mrpackethead/bbb_eagle/BeagleBone_Black_egl.brd

## EAGLE design BeagleBone_Black_egl.brd (2013-08-05)

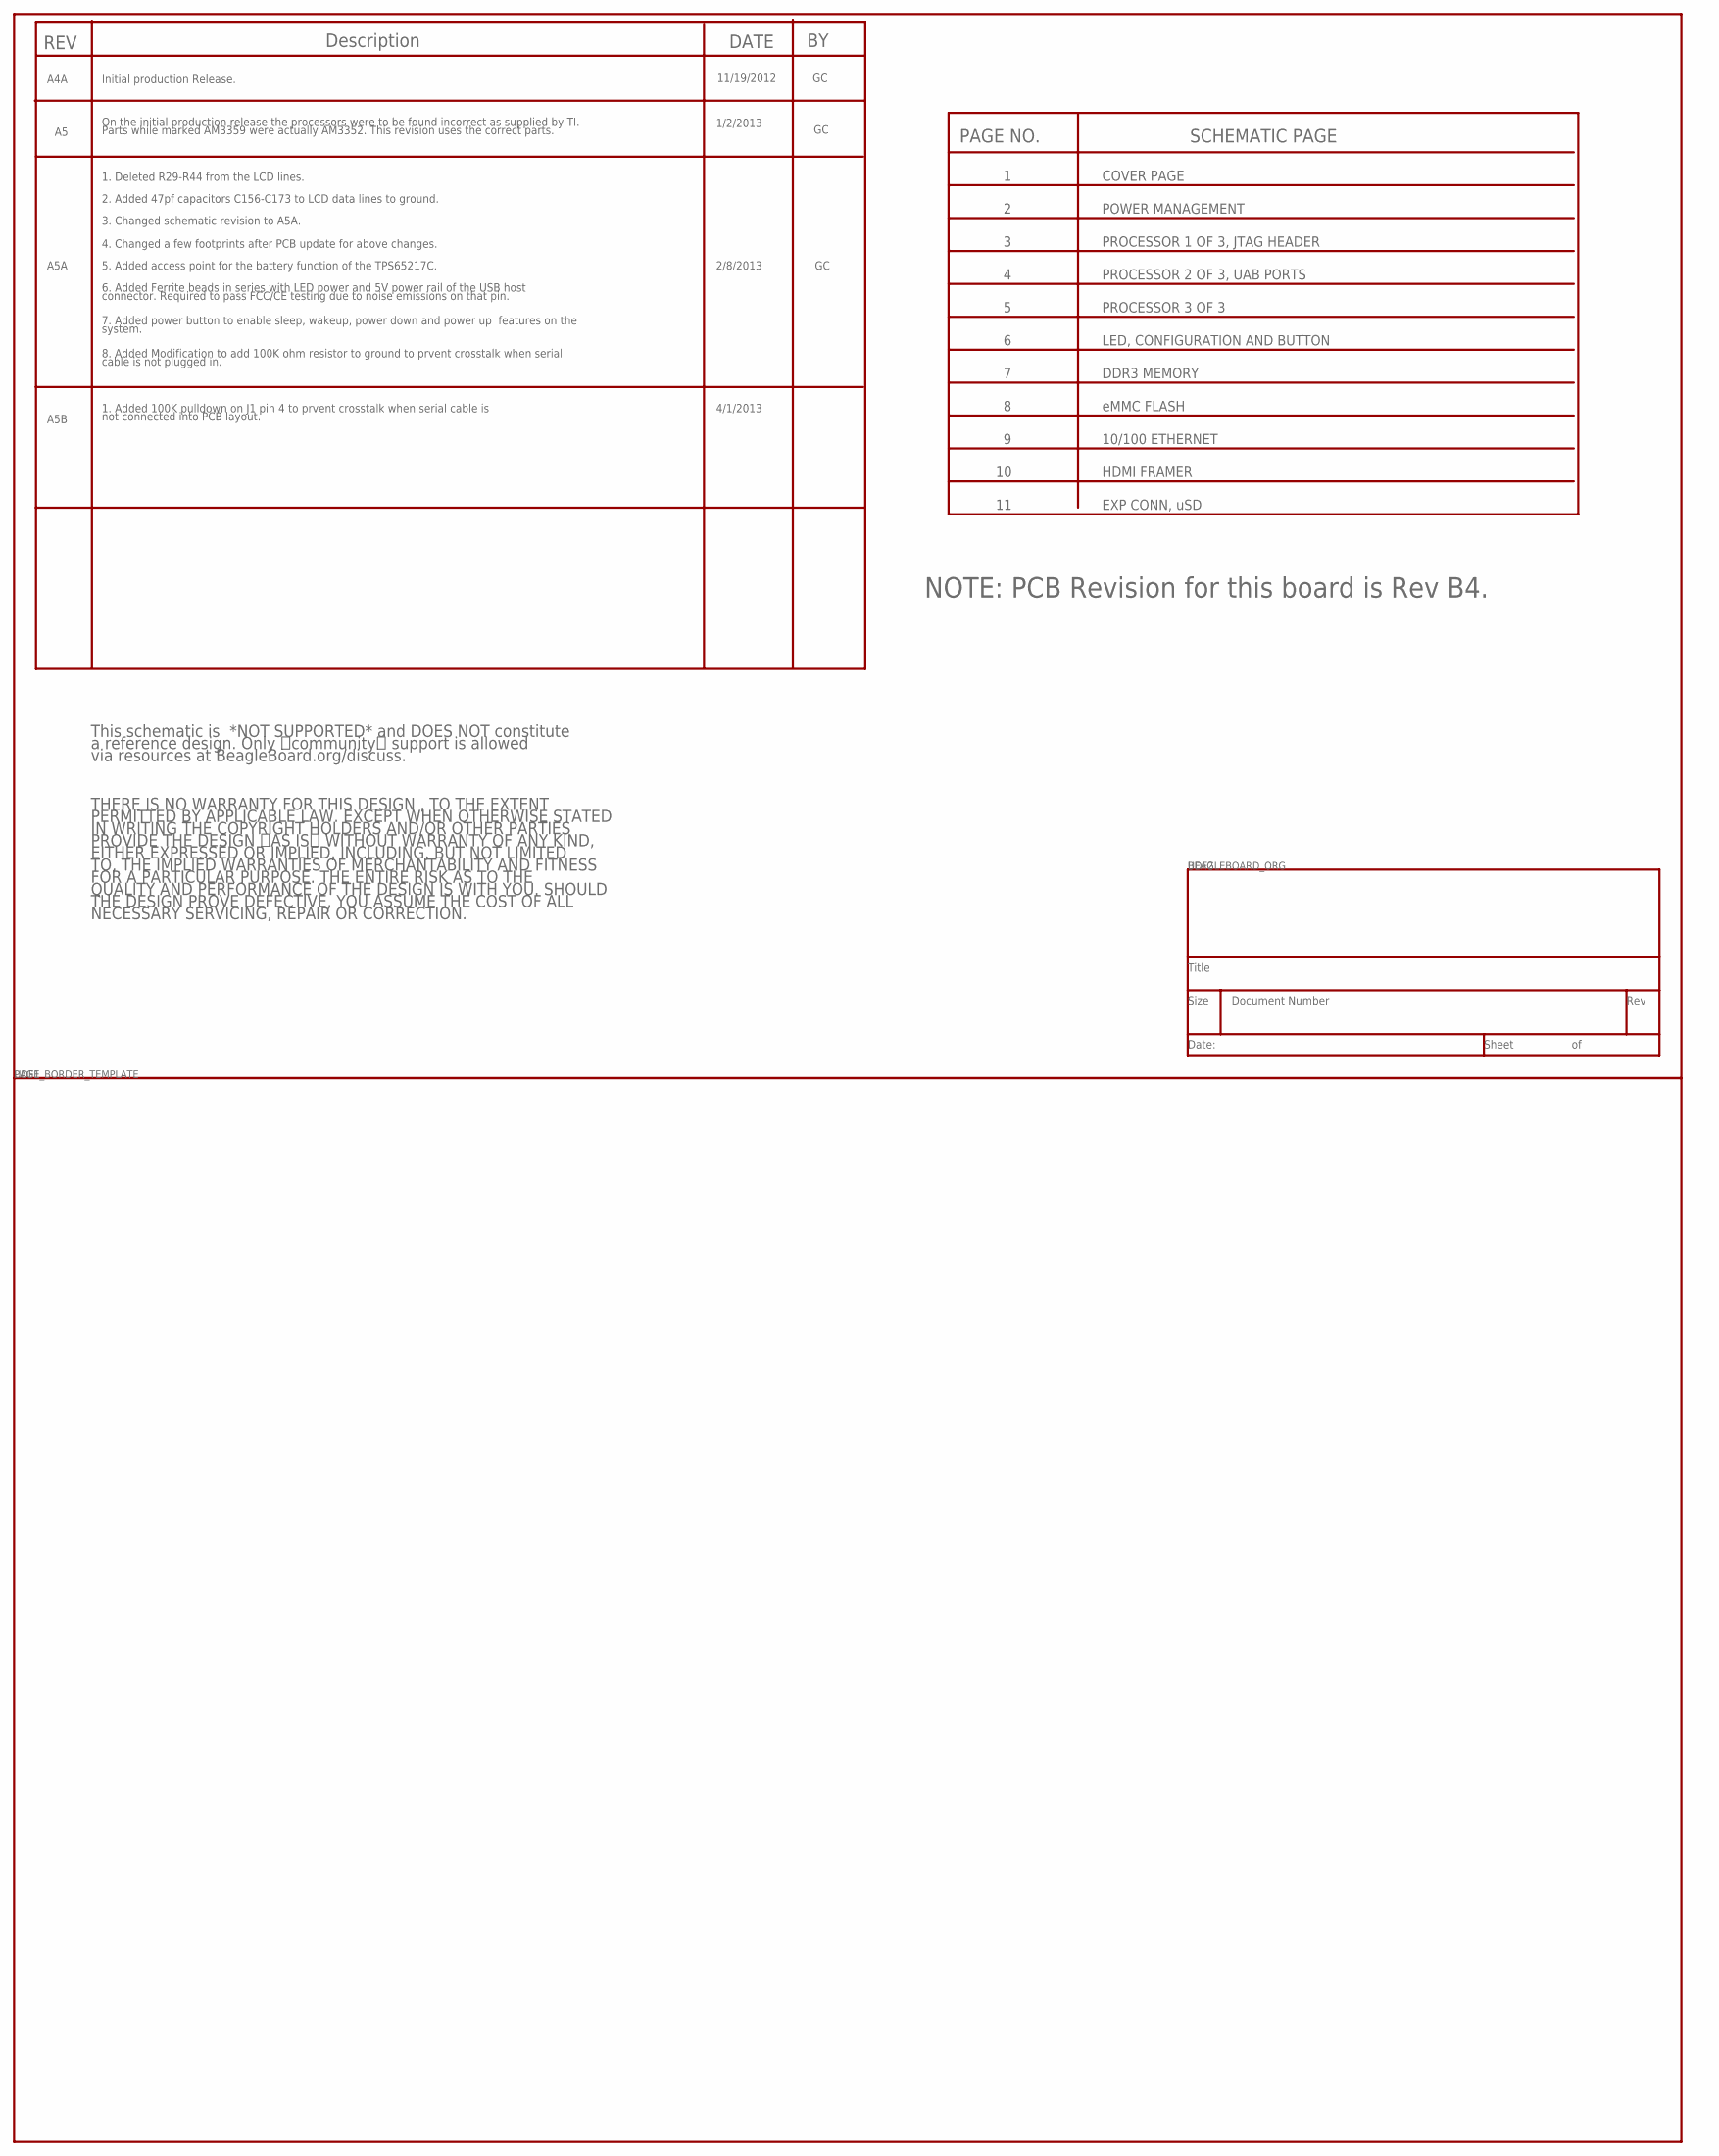
[picture p1: schematic BeagleBone_Black_egl.sch, sheet 1]

Notes on the sheet:
eMMC FLASH
HDMI FRAMER
10/100 ETHERNET
DDR3 MEMORY
PROCESSOR 2 OF 3, UAB PORTS
LED, CONFIGURATION AND BUTTON
SCHEMATIC PAGE
PAGE NO.
PROCESSOR 3 OF 3
PROCESSOR 1 OF 3, JTAG HEADER
POWER MANAGEMENT
COVER PAGE
This schematic is *NOT SUPPORTED* and DOES NOT constitute
a reference design. Only community support is allowed
via resources at BeagleBoard.org/discuss.
THERE IS NO WARRANTY FOR THIS DESIGN , TO THE EXTENT
PERMITTED BY APPLICABLE LAW. EXCEPT WHEN OTHERWISE STATED
IN WRITING THE COPYRIGHT HOLDERS AND/OR OTHER PARTIES
PROVIDE THE DESIGN AS IS WITHOUT WARRANTY OF ANY KIND,
EITHER EXPRESSED OR IMPLIED, INCLUDING, BUT NOT LIMITED
TO, THE IMPLIED WARRANTIES OF MERCHANTABILITY AND FITNESS
FOR A PARTICULAR PURPOSE. THE ENTIRE RISK AS TO THE
QUALITY AND PERFORMANCE OF THE DESIGN IS WITH YOU. SHOULD
THE DESIGN PROVE DEFECTIVE, YOU ASSUME THE COST OF ALL
NECESSARY SERVICING, REPAIR OR CORRECTION.
EXP CONN, uSD
NOTE: PCB Revision for this board is Rev B4.
REV
Description
DATE
11/19/2012
Initial production Release.
A4A
On the initial production release the processors were to be found incorrect as supplied by TI.
Parts while marked AM3359 were actually AM3352. This revision uses the correct parts.
1/2/2013
1. Deleted R29-R44 from the LCD lines.
2. Added 47pf capacitors C156-C173 to LCD data lines to ground.
3. Changed schematic revision to A5A.
A5A
4. Changed a few footprints after PCB update for above changes.
5. Added access point for the battery function of the TPS65217C.
2/8/2013
7. Added power button to enable sleep, wakeup, power down and power up features on the
system.
6. Added Ferrite beads in series with LED power and 5V power rail of the USB host
connector. Required to pass FCC/CE testing due to noise emissions on that pin.
A5B
1. Added 100K pulldown on J1 pin 4 to prvent crosstalk when serial cable is
not connected into PCB layout.
4/1/2013
8. Added Modification to add 100K ohm resistor to ground to prvent crosstalk when serial
cable is not plugged in.

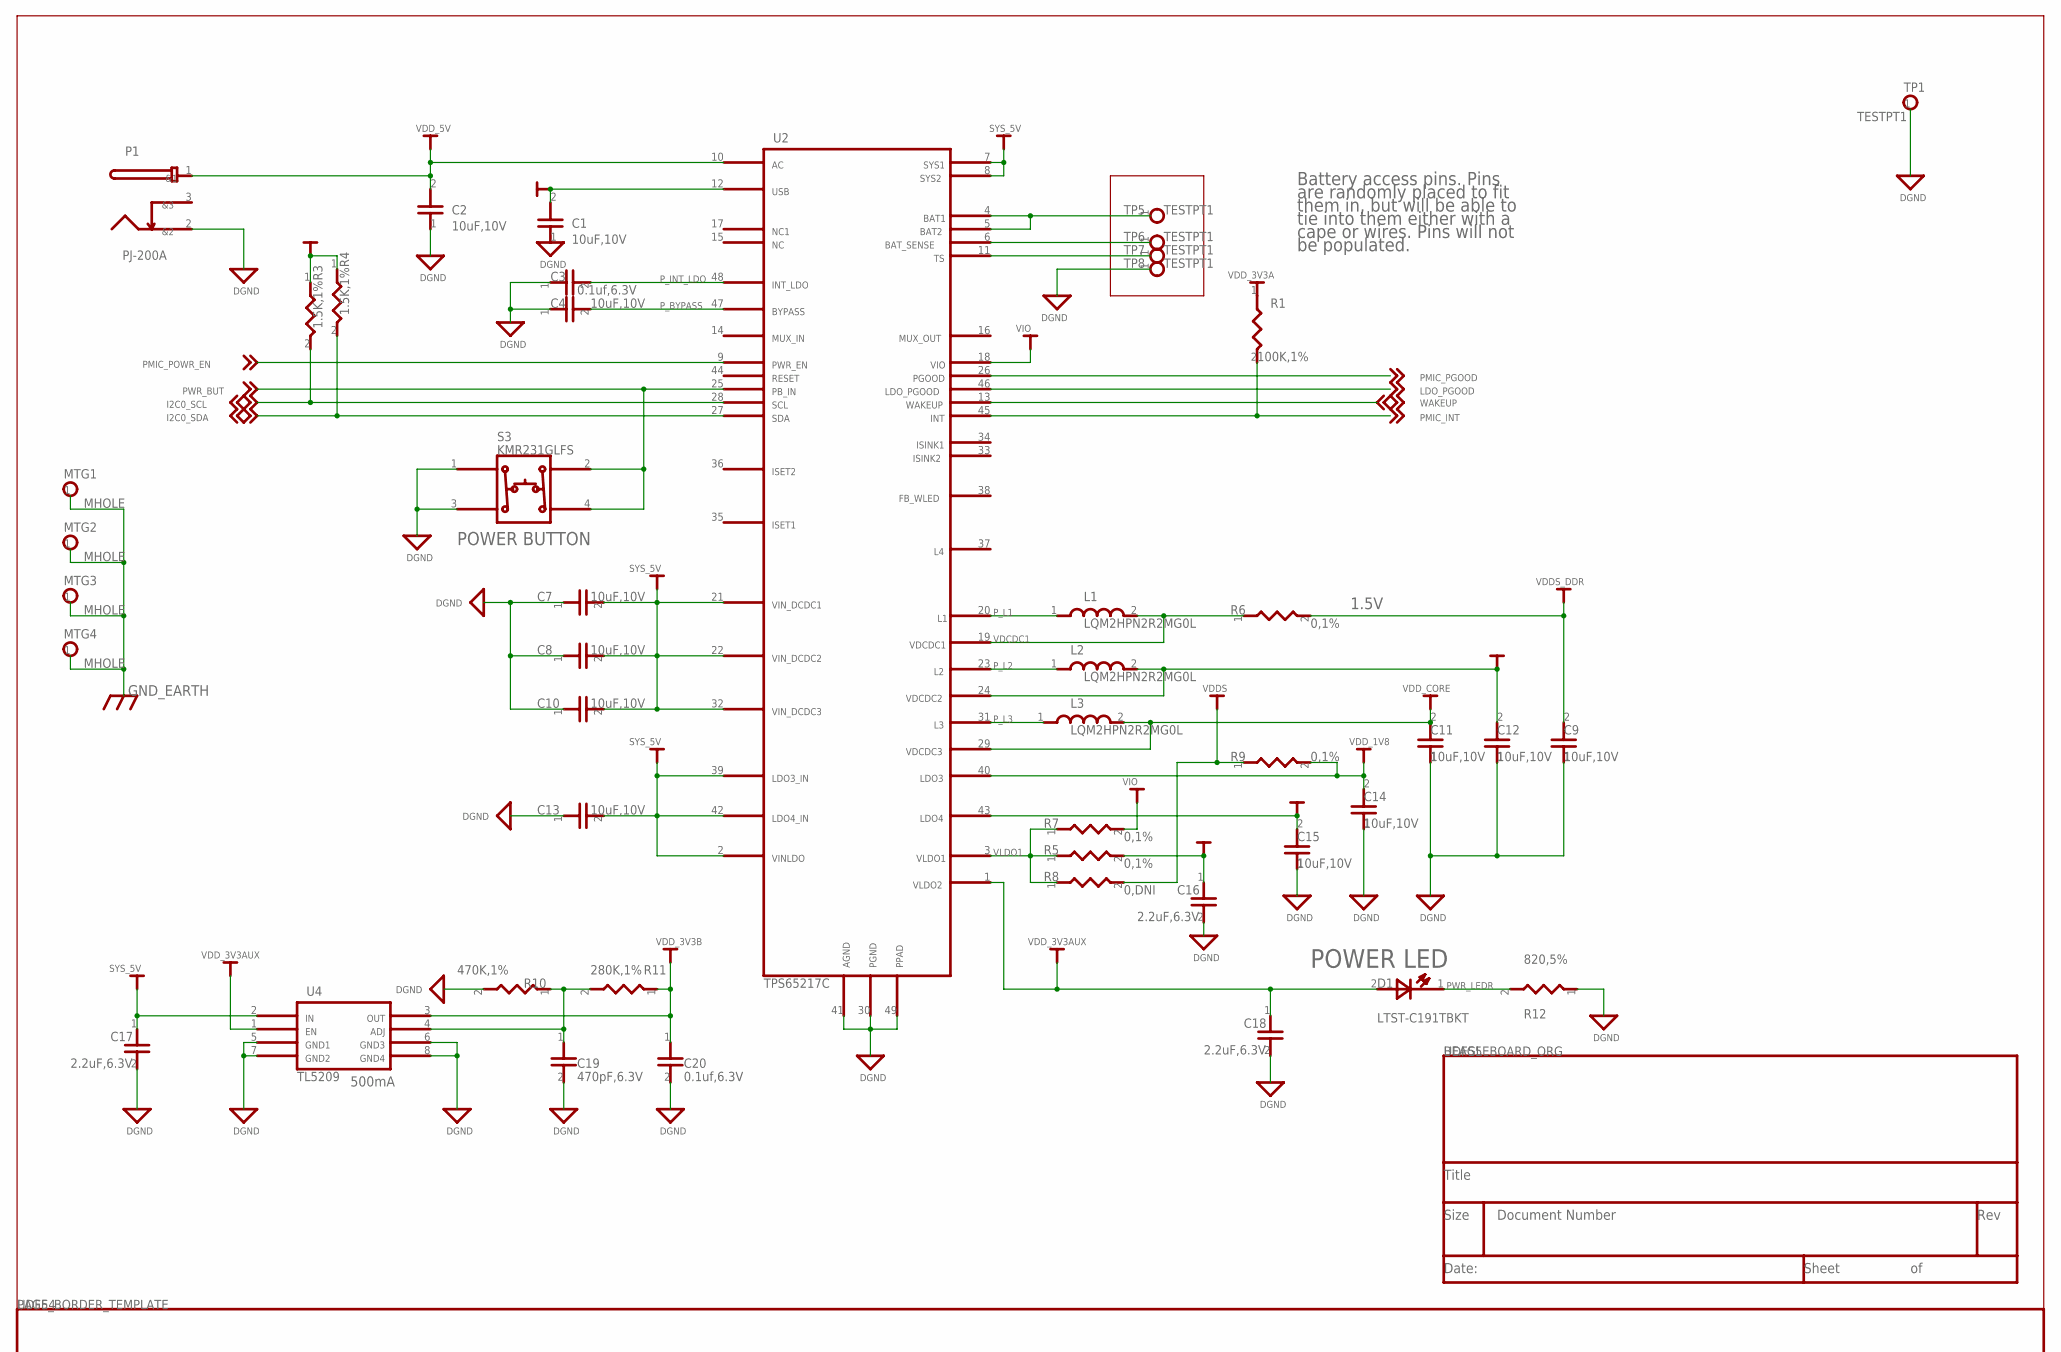
[picture p2: schematic BeagleBone_Black_egl.sch, sheet 2, part in row 1, column 1]

Parts:
C1, C2, C4, C7, C8, C9, C10, C11, C12, C13, C14, C15: 10uF,10V; 805
C3, C20: 0.1uf,6.3V; 402
C16, C17, C18: 2.2uF,6.3V; 402
C19: 470pF,6.3V; 402
D1: LTST-C191TBKT; LED_0603
L1, L2, L3: LQM2HPN2R2MG0L; 2520
MTG1, MTG2, MTG3, MTG4: MHOLE; MTGH200C125D_PL
P1: PJ-200A; CONN3-PWR-PJ102A
R1: 100K,1%; 402
R3, R4: 1.5K,1%; 402
R5, R6, R7, R9: 0,1%; 402
R8: 0,DNI; 402
R10: 470K,1%; 402
R11: 280K,1%; 402
R12: 820,5%; 402
S3: KMR231GLFS; SW4SMD_63X161LS
TP1: TESTPT1; TP1-8040
TP5, TP6, TP7, TP8: TESTPT1; TP60C33D
U2: TPS65217C; U_48_RSL
U4: TL5209; SO8-25X75

Connections:
DGND: C1.1, C2.1, C3.1, C4.1, C7.1, C8.1, C9.1, C10.1, C11.1, C12.1, C13.1, C14.1, C15.1, C16.2, C17.2, C18.2, C19.2, C20.2, P1.2 (3), R10.2, R12.1, S3.1, S3.3, TP1.1, TP8.1, U2.30 (46), U2.41 (45), U2.49, U4.5 (3), U4.6, U4.7, U4.8; also elsewhere on the board
GND_EARTH: MTG1.1, MTG2.1, MTG3.1, MTG4.1; also elsewhere on the board
I2C0_SCL: R3.2, U2.28 (16); also elsewhere on the board
I2C0_SDA: R4.2, U2.27 (17); also elsewhere on the board
LDO_PGOOD: U2.46 (26); also elsewhere on the board
N21757673: C19.1, R10.1, R11.2, U4.4 (5)
N22420400: TP5.1, U2.4 (5), U2.5 (6)
N22420444: TP6.1, U2.6 (7)
N22420447: TP7.1, U2.11 (8)
PMIC_INT: R1.2, U2.45 (28); also elsewhere on the board
PMIC_PGOOD: U2.26 (25); also elsewhere on the board
PMIC_POWR_EN: U2.9 (13); also elsewhere on the board
PWR_BUT: S3.2, S3.4, U2.25 (15); also elsewhere on the board
PWR_LEDR: D1.1, R12.2
P_BYPASS: C4.2, U2.47 (12)
P_INT_LDO: C3.2, U2.48 (11)
P_L1: L1.1, U2.20 (30)
P_L2: L2.1, U2.23 (33)
P_L3: L3.1, U2.31 (36)
SYS_5V: C7.2, C8.2, C10.2, C13.2, C17.1, U2.2 (42), U2.7 (3), U2.8 (4), U2.21 (29), U2.22 (32), U2.32 (35), U2.39 (40), U2.42 (41), U4.2 (1); also elsewhere on the board
USB_DC: C1.2, U2.12 (2); also elsewhere on the board
VDCDC1: L1.2, R6.1, U2.19 (31)
VDDS: R8.2, R9.1; also elsewhere on the board
VDDS_DDR: C9.2, R6.2; also elsewhere on the board
VDD_1V8: C14.2, R9.2, U2.40 (38); also elsewhere on the board
VDD_3V3A: C15.2, R1.1, R3.1, R4.1, U2.43 (39); also elsewhere on the board
VDD_3V3AUX: C18.1, D1.2, U2.1 (44), U4.1 (4)
VDD_3V3B: C20.1, R11.1, U4.3 (2); also elsewhere on the board
VDD_5V: C2.2, P1.1, U2.10 (1); also elsewhere on the board
VDD_CORE: C11.2, L3.2, U2.29 (37); also elsewhere on the board
VDD_MPU: C12.2, L2.2, U2.24 (34); also elsewhere on the board
VIO: R7.2, U2.18 (24)
VLDO1: R5.1, R7.1, R8.1, U2.3 (43)
VRTC: C16.1, R5.2; also elsewhere on the board
WAKEUP: U2.13 (27); also elsewhere on the board

Notes on the sheet:
POWER LED
1.5V
500mA
Battery access pins. Pins
are randomly placed to fit
them in, but will be able to
tie into them either with a
cape or wires. Pins will not
be populated.
POWER BUTTON
DGND
GND_EARTH
I2C0_SCL
I2C0_SDA
LDO_PGOOD
PMIC_INT
PMIC_PGOOD
PMIC_POWR_EN
PWR_BUT
PWR_LEDR
P_BYPASS
P_INT_LDO
P_L1
P_L2
P_L3
SYS_5V
VDCDC1
VDDS
VDDS_DDR
VDD_1V8
VDD_3V3A
VDD_3V3AUX
VDD_3V3B
VDD_5V
VDD_CORE
VIO
VLDO1
WAKEUP

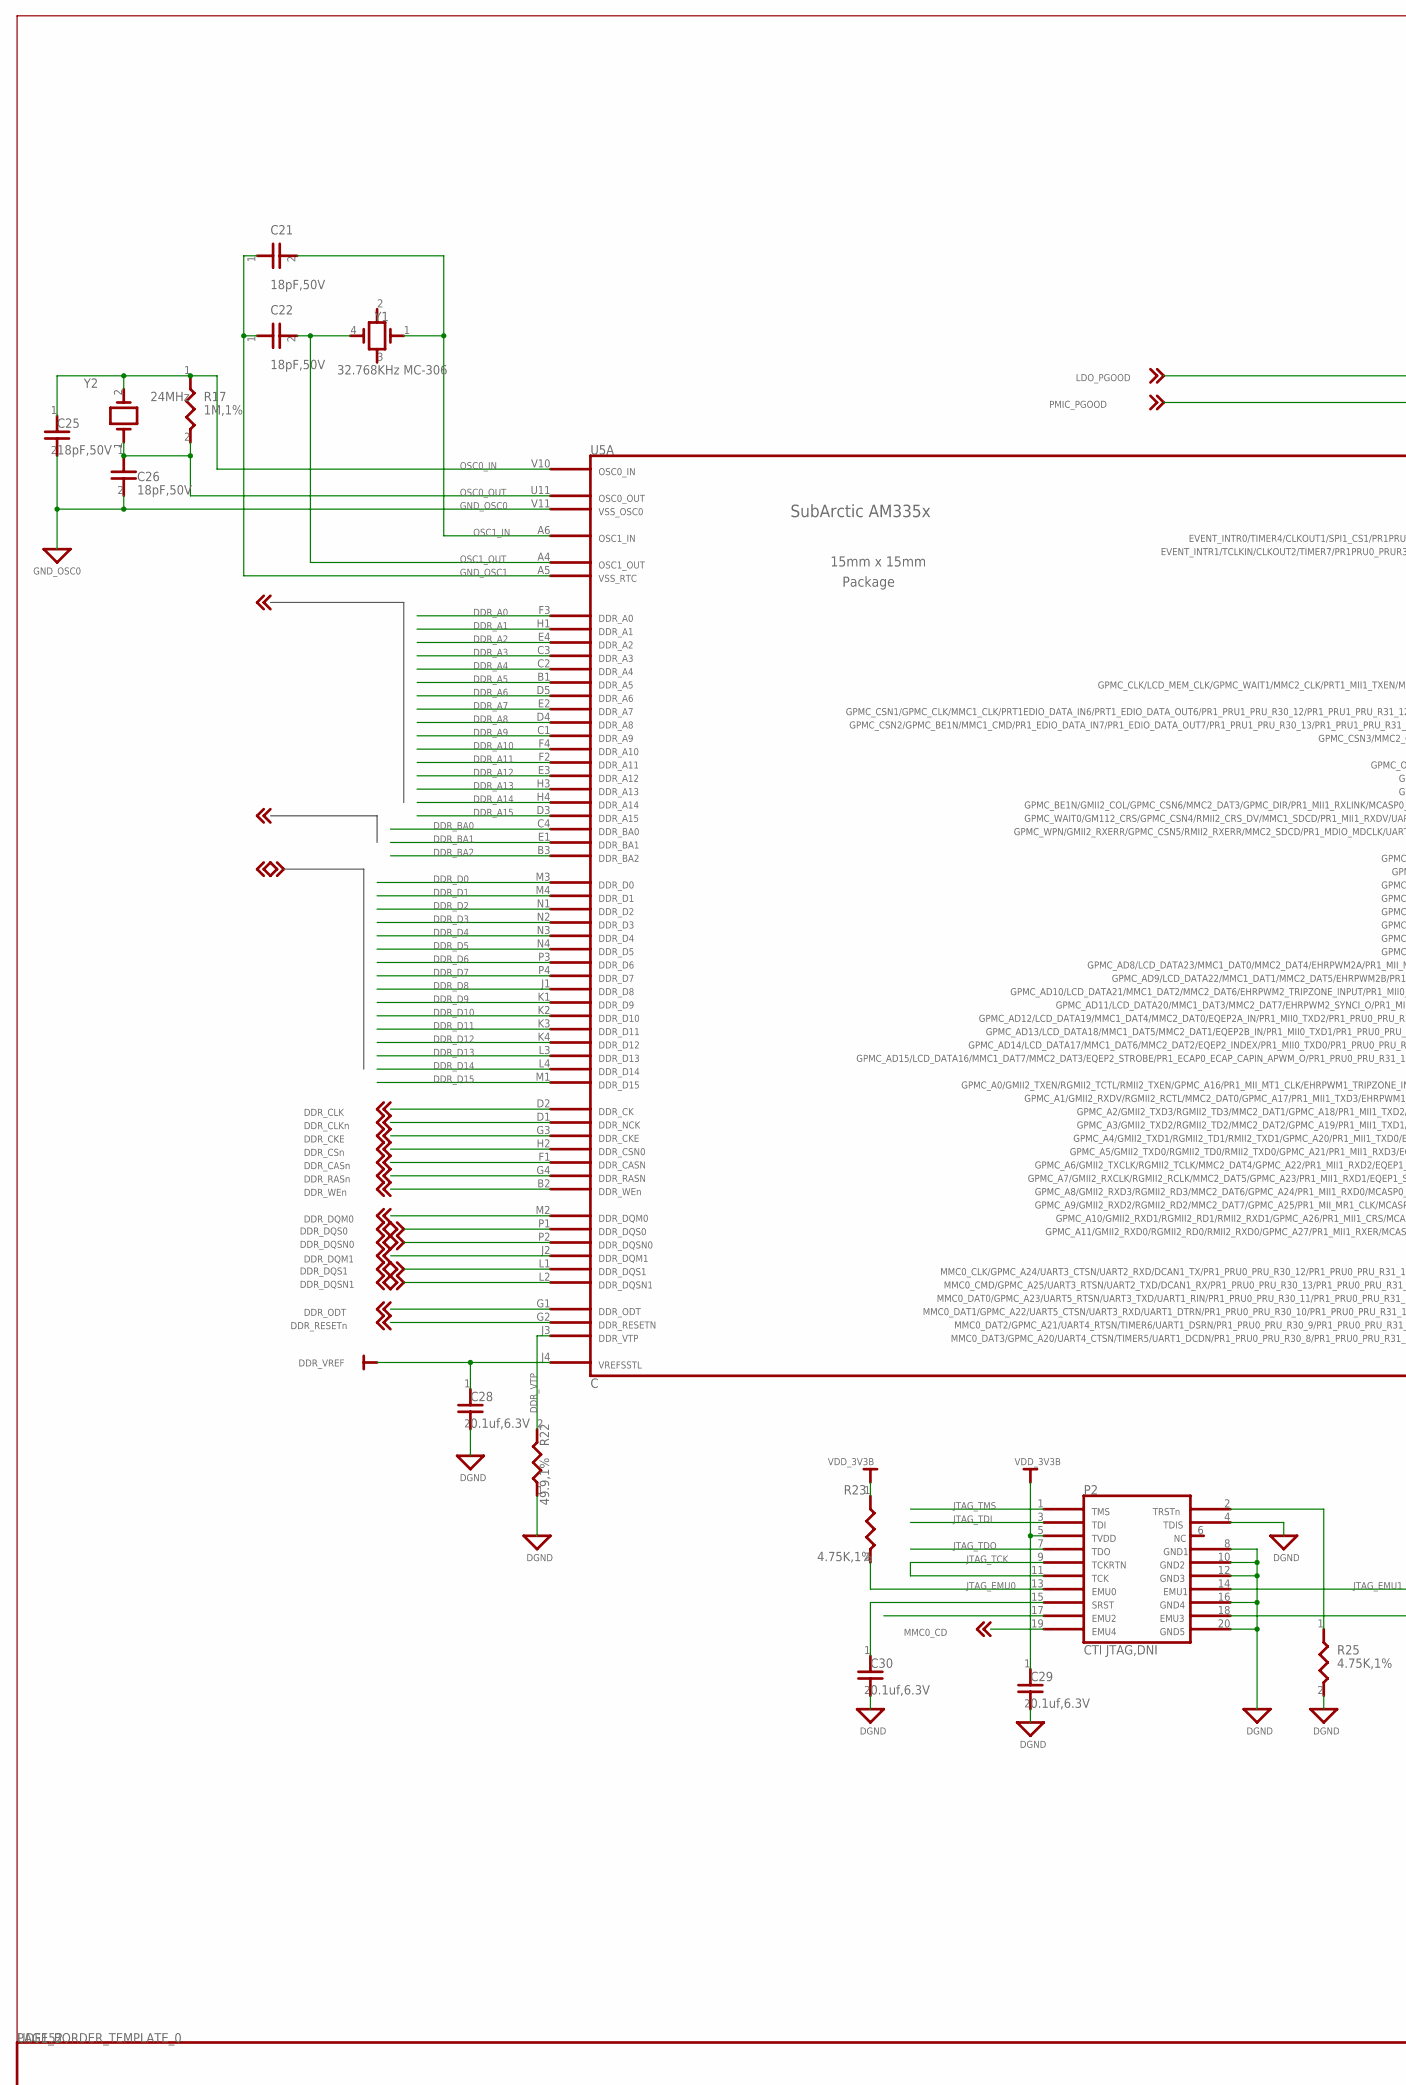
[picture p3: schematic BeagleBone_Black_egl.sch, sheet 3, part in row 1, column 1]

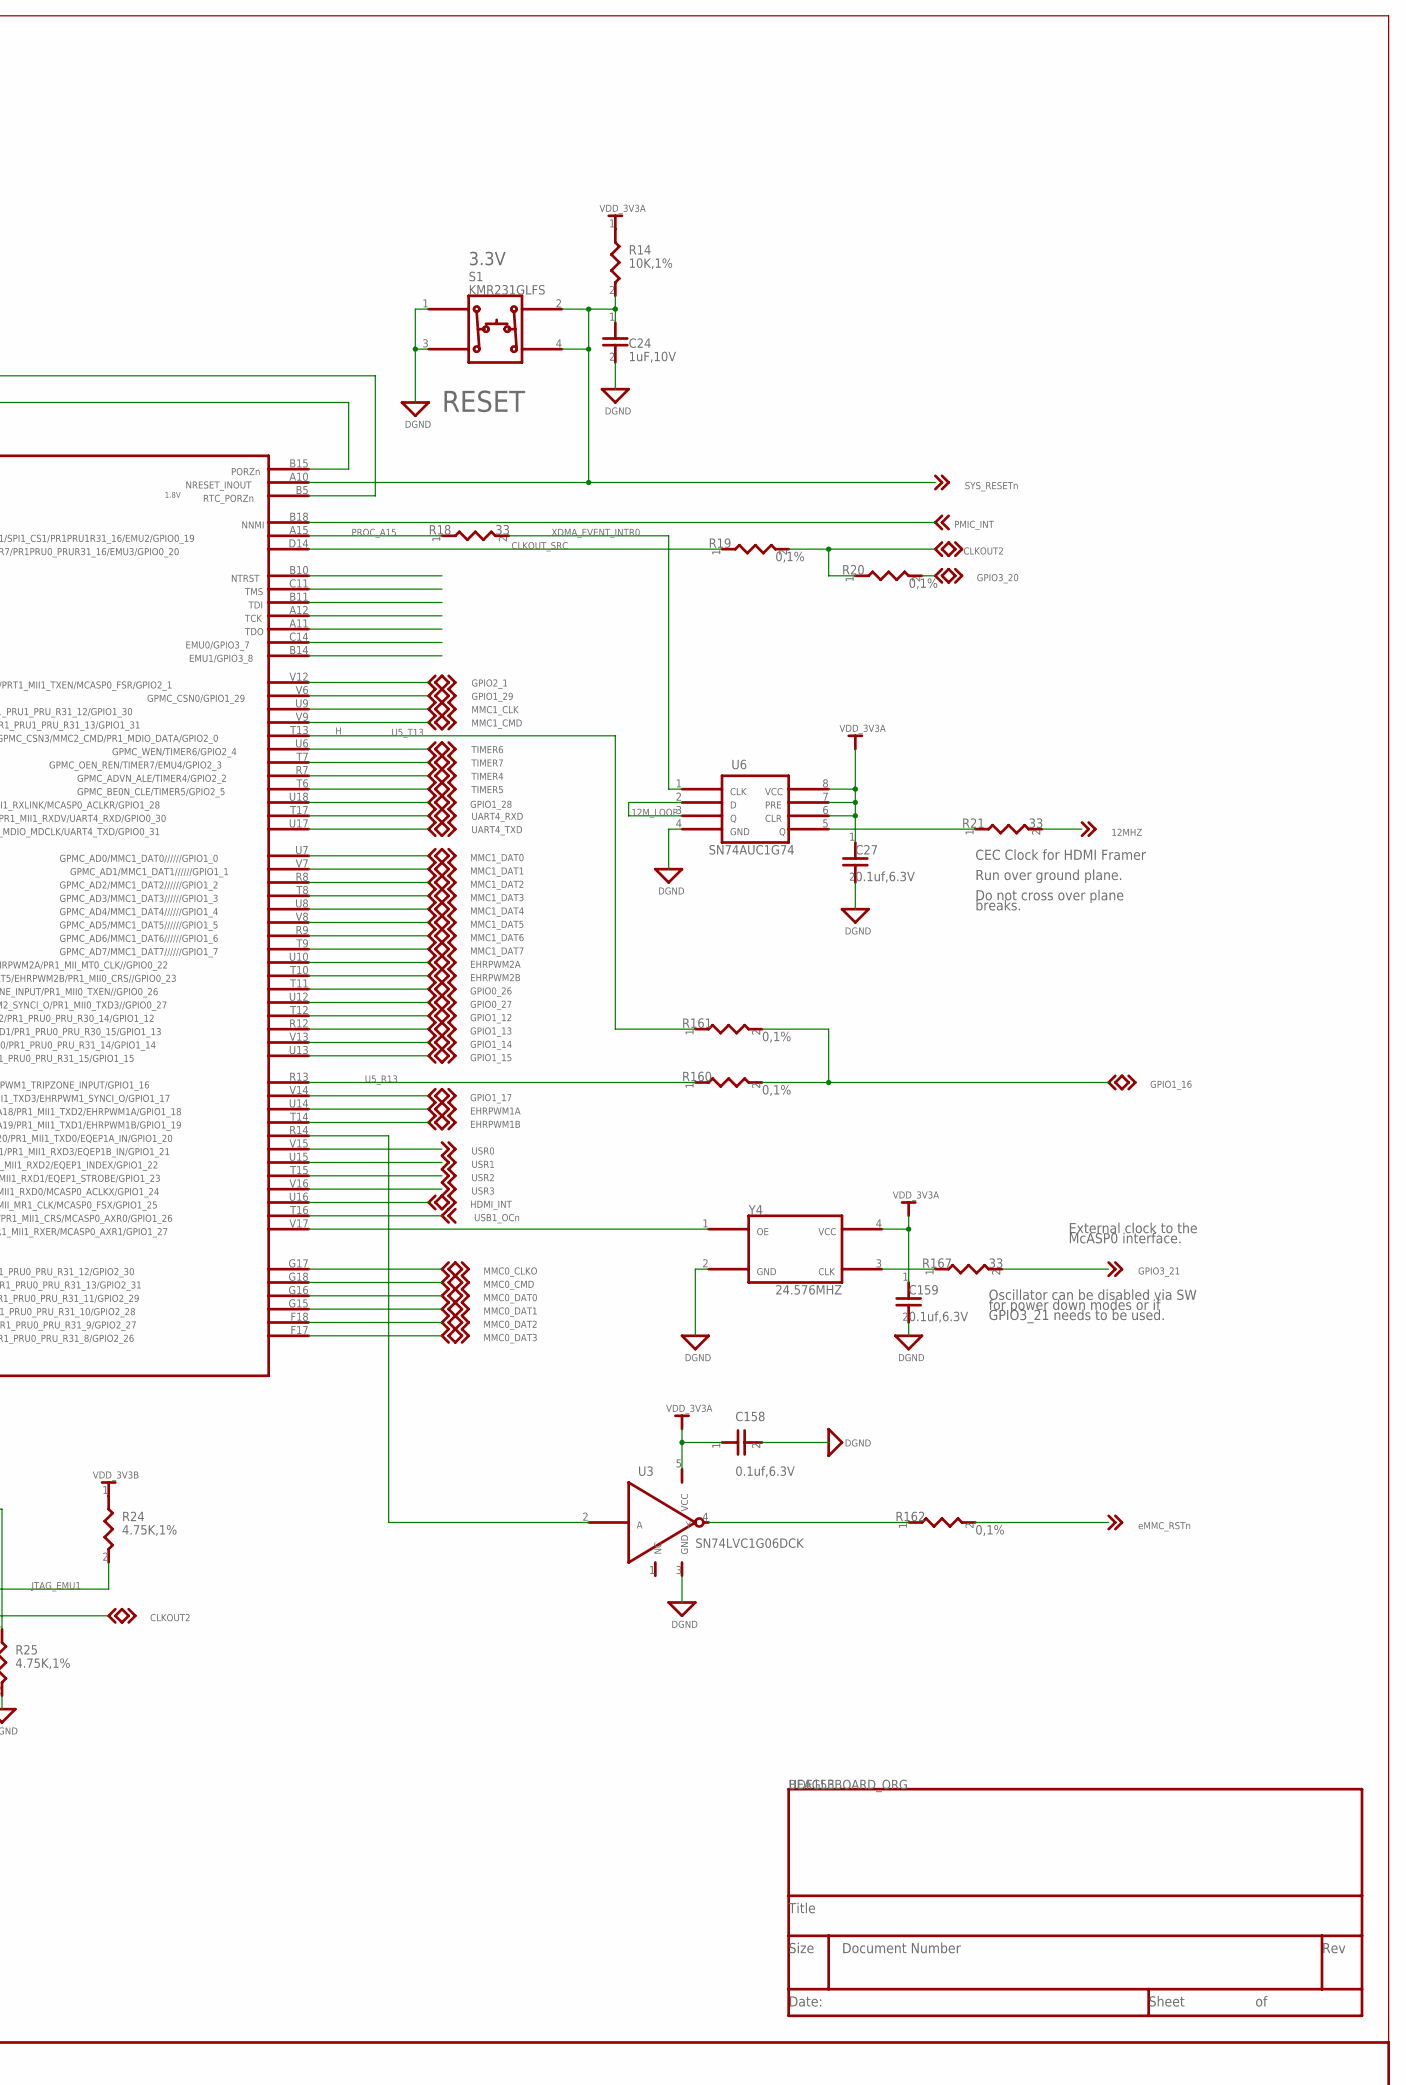
[picture p4: schematic BeagleBone_Black_egl.sch, sheet 3, part in row 1, column 2]

Parts:
C21, C22, C25, C26: 18pF,50V; 402
C24: 1uF,10V; 402
C27, C28, C29, C30, C158, C159: 0.1uf,6.3V; 402
P2: CTI JTAG,DNI; HEADER10X2_SMD
R14: 10K,1%; 402
R17: 1M,1%; 402
R18, R21, R167: 33; 0402
R19, R20, R160, R161, R162: 0,1%; 402
R22: 49.9,1%; 402
R23, R24, R25: 4.75K,1%; 402
S1: KMR231GLFS; SW4SMD_63X161LS
U3: SN74LVC1G06DCK; DCK5_2P15X1P4
U5: C; AM33XX_15X15
U6: SN74AUC1G74; SOP8_DCT
Y1: 32.768KHz MC-306; XTAL4_126-216SMD
Y2: 24MHz; XTAL150SMD_125X196
Y4: 24.576MHZ; OSC4_61X65LS_79X98SMD

Connections:
12MHZ: R21.2; also elsewhere on the board
12M_LOOP: U6.2, U6.3
CLKOUT2: P2.18 (19), R19.2, R20.1; also elsewhere on the board
CLKOUT_SRC: R19.1, U5.D14 (54)
DDR_A0: U5.F3 (61); also elsewhere on the board
DDR_A1: U5.H1 (62); also elsewhere on the board
DDR_A2: U5.E4 (63); also elsewhere on the board
DDR_A3: U5.C3 (64); also elsewhere on the board
DDR_A4: U5.C2 (65); also elsewhere on the board
DDR_A5: U5.B1 (66); also elsewhere on the board
DDR_A6: U5.D5 (67); also elsewhere on the board
DDR_A7: U5.E2 (68); also elsewhere on the board
DDR_A8: U5.D4 (69); also elsewhere on the board
DDR_A9: U5.C1 (70); also elsewhere on the board
DDR_A10: U5.F4 (71); also elsewhere on the board
DDR_A11: U5.F2 (72); also elsewhere on the board
DDR_A12: U5.E3 (73); also elsewhere on the board
DDR_A13: U5.H3 (74); also elsewhere on the board
DDR_A14: U5.H4 (75); also elsewhere on the board
DDR_A15: U5.D3 (115); also elsewhere on the board
DDR_BA0: U5.C4 (98); also elsewhere on the board
DDR_BA1: U5.E1 (99); also elsewhere on the board
DDR_BA2: U5.B3 (100); also elsewhere on the board
DDR_CASN: U5.F1 (95); also elsewhere on the board
DDR_CKE: U5.G3 (112); also elsewhere on the board
DDR_CLK: U5.D2 (92); also elsewhere on the board
DDR_CLKN: U5.D1 (93); also elsewhere on the board
DDR_CSN: U5.H2 (94); also elsewhere on the board
DDR_D0: U5.M3 (76); also elsewhere on the board
DDR_D1: U5.M4 (77); also elsewhere on the board
DDR_D2: U5.N1 (78); also elsewhere on the board
DDR_D3: U5.N2 (79); also elsewhere on the board
DDR_D4: U5.N3 (80); also elsewhere on the board
DDR_D5: U5.N4 (81); also elsewhere on the board
DDR_D6: U5.P3 (82); also elsewhere on the board
DDR_D7: U5.P4 (83); also elsewhere on the board
DDR_D8: U5.J1 (84); also elsewhere on the board
DDR_D9: U5.K1 (85); also elsewhere on the board
DDR_D10: U5.K2 (86); also elsewhere on the board
DDR_D11: U5.K3 (87); also elsewhere on the board
DDR_D12: U5.K4 (88); also elsewhere on the board
DDR_D13: U5.L3 (89); also elsewhere on the board
DDR_D14: U5.L4 (90); also elsewhere on the board
DDR_D15: U5.M1 (91); also elsewhere on the board
DDR_DQM0: U5.M2 (101); also elsewhere on the board
DDR_DQM1: U5.J2 (104); also elsewhere on the board
DDR_DQS0: U5.P1 (102); also elsewhere on the board
DDR_DQS1: U5.L1 (105); also elsewhere on the board
DDR_DQSN0: U5.P2 (103); also elsewhere on the board
DDR_DQSN1: U5.L2 (106); also elsewhere on the board
DDR_ODT: U5.G1 (107); also elsewhere on the board
DDR_RASN: U5.G4 (96); also elsewhere on the board
DDR_RESETN: U5.G2 (113); also elsewhere on the board
DDR_VREF: C28.1, U5.J4 (117); also elsewhere on the board
DDR_VTP: R22.2, U5.J3 (114)
DDR_WEN: U5.B2 (97); also elsewhere on the board
DGND: C24.2, C27.2, C28.2, C29.2, C30.2, C158.2, C159.2, P2.4 (12), P2.8 (14), P2.10 (15), P2.12 (16), P2.16 (18), P2.20, R22.1, R25.2, S1.1, S1.3, U3.3, U6.4, Y4.2; also elsewhere on the board
EHRPWM1A: U5.U14 (34); also elsewhere on the board
EHRPWM1B: U5.T14 (35); also elsewhere on the board
EHRPWM2A: U5.U10 (24); also elsewhere on the board
EHRPWM2B: U5.T10 (25); also elsewhere on the board
EMMC_RSTN: R162.2; also elsewhere on the board
GND_OSC0: C25.2, C26.2, U5.V11 (110)
GND_OSC1: C21.1, C22.1, U5.A5 (109)
GPIO0_26: U5.T11 (26); also elsewhere on the board
GPIO0_27: U5.U12 (27); also elsewhere on the board
GPIO1_12: U5.T12 (28); also elsewhere on the board
GPIO1_13: U5.R12 (29); also elsewhere on the board
GPIO1_14: U5.V13 (30); also elsewhere on the board
GPIO1_15: U5.U13 (31); also elsewhere on the board
GPIO1_16: R160.2, R161.2; also elsewhere on the board
GPIO1_17: U5.V14 (33); also elsewhere on the board
GPIO1_28: U5.U18 (14); also elsewhere on the board
GPIO1_29: U5.V6 (6); also elsewhere on the board
GPIO2_1: U5.V12 (5); also elsewhere on the board
GPIO3_20: R20.2; also elsewhere on the board
GPIO3_21: R167.2; also elsewhere on the board
HDMICLK_DISN: U5.V17 (43), Y4.1
HDMI_INT: U5.U16 (41); also elsewhere on the board
JTAG_EMU0: P2.13 (7), R23.2, U5.C14 (60)
JTAG_EMU1: P2.14 (17), R24.2, U5.B14 (108)
JTAG_TCK: P2.9 (5), P2.11 (6), U5.A12 (57)
JTAG_TDI: P2.3 (2), U5.B11 (58)
JTAG_TDO: P2.7 (4), U5.A11 (59)
JTAG_TMS: P2.1, U5.C11 (55)
JTAG_TRSTN: P2.2 (11), R25.1, U5.B10 (56)
LDO_PGOOD: U5.B5 (116); also elsewhere on the board
MMC0_CD: P2.19 (10); also elsewhere on the board
MMC0_CLKO: U5.G17 (44); also elsewhere on the board
MMC0_CMD: U5.G18 (45); also elsewhere on the board
MMC0_DAT0: U5.G16 (46); also elsewhere on the board
MMC0_DAT1: U5.G15 (47); also elsewhere on the board
MMC0_DAT2: U5.F18 (48); also elsewhere on the board
MMC0_DAT3: U5.F17 (49); also elsewhere on the board
MMC1_CLK: U5.U9 (7); also elsewhere on the board
MMC1_CMD: U5.V9 (8); also elsewhere on the board
MMC1_DAT0: U5.U7 (16); also elsewhere on the board
MMC1_DAT1: U5.V7 (17); also elsewhere on the board
MMC1_DAT2: U5.R8 (18); also elsewhere on the board
MMC1_DAT3: U5.T8 (19); also elsewhere on the board
MMC1_DAT4: U5.U8 (20); also elsewhere on the board
MMC1_DAT5: U5.V8 (21); also elsewhere on the board
MMC1_DAT6: U5.R9 (22); also elsewhere on the board
MMC1_DAT7: U5.T9 (23); also elsewhere on the board
N22248684: R167.1, Y4.3 (4)
N22248838: R21.1, U6.5
N22287501: R162.1, U3.4 (2)
N22287555: U3.2 (1), U5.R14 (36)
OSC0_IN: C25.1, R17.1, U5.V10 (3), Y2.2
OSC0_OUT: C26.1, R17.2, U5.U11 (4), Y2.1
OSC1_IN: C21.2, U5.A6 (1), Y1.1
OSC1_OUT: C22.2, U5.A4 (2), Y1.4 (2)
PMIC_INT: U5.B18 (52); also elsewhere on the board
PMIC_PGOOD: U5.B15 (50); also elsewhere on the board
PROC_A15: R18.1, U5.A15 (53)
SYS_RESETN: C24.1, C30.1, P2.15 (8), R14.2, S1.2, S1.4, U5.A10 (51); also elsewhere on the board
TIMER4: U5.R7 (12); also elsewhere on the board
TIMER5: U5.T6 (13); also elsewhere on the board
TIMER6: U5.U6 (9); also elsewhere on the board
TIMER7: U5.T7 (10); also elsewhere on the board
U5_R13: R160.1, U5.R13 (32)
U5_T13: R161.1, U5.T13 (11)
UART4_RXD: U5.T17 (15); also elsewhere on the board
UART4_TXD: U5.U17 (111); also elsewhere on the board
USB1_OCN: U5.T16 (42); also elsewhere on the board
USR0: U5.V15 (37); also elsewhere on the board
USR1: U5.U15 (38); also elsewhere on the board
USR2: U5.T15 (39); also elsewhere on the board
USR3: U5.V16 (40); also elsewhere on the board
VDD_3V3A: C27.1, C158.1, C159.1, R14.1, U3.5 (4), U6.6, U6.7, U6.8, Y4.4 (3); also elsewhere on the board
VDD_3V3B: C29.1, P2.5 (3), R23.1, R24.1; also elsewhere on the board
XDMA_EVENT_INTR0: P2.17 (9), R18.2, U6.1

Notes on the sheet:
RESET
CEC Clock for HDMI Framer
Run over ground plane.
Do not cross over plane
breaks.
3.3V
External clock to the
McASP0 interface.
Oscillator can be disabled via SW
for power down modes or if
GPIO3_21 needs to be used.
DGND
LDO_PGOOD
PMIC_INT
PMIC_PGOOD
VDD_3V3A
VDD_3V3B
12MHZ
12M_LOOP
CLKOUT2
CLKOUT_SRC
DDR_A0
DDR_A1
DDR_A10
DDR_A11
DDR_A12
DDR_A13
DDR_A14
DDR_A15
DDR_A2
DDR_A3
DDR_A4
DDR_A5
DDR_A6
DDR_A7
DDR_A8
DDR_A9
DDR_BA0
DDR_BA1
DDR_BA2
DDR_CASn
DDR_CKE
DDR_CLK
DDR_CLKn
DDR_CSn
DDR_D0
DDR_D1
DDR_D10
DDR_D11
DDR_D12
DDR_D13
DDR_D14
DDR_D15
DDR_D2
DDR_D3
DDR_D4
DDR_D5
DDR_D6
DDR_D7
DDR_D8
DDR_D9
DDR_DQM0
DDR_DQM1
DDR_DQS0
DDR_DQS1
DDR_DQSN0
DDR_DQSN1
DDR_ODT
DDR_RASn
DDR_RESETn
DDR_VREF
DDR_VTP
DDR_WEn
EHRPWM1A
EHRPWM1B
EHRPWM2A
EHRPWM2B
eMMC_RSTn
GND_OSC0
GND_OSC1
GPIO0_26
GPIO0_27
GPIO1_12
GPIO1_13
GPIO1_14
GPIO1_15
GPIO1_16
GPIO1_17
GPIO1_28
GPIO1_29
GPIO2_1
GPIO3_20
GPIO3_21
HDMI_INT
JTAG_EMU0
JTAG_EMU1
JTAG_TCK
JTAG_TDI
JTAG_TDO
JTAG_TMS
MMC0_CD
MMC0_CLKO
MMC0_CMD
MMC0_DAT0
MMC0_DAT1
MMC0_DAT2
MMC0_DAT3
MMC1_CLK
MMC1_CMD
MMC1_DAT0
MMC1_DAT1
MMC1_DAT2
MMC1_DAT3
MMC1_DAT4
MMC1_DAT5
MMC1_DAT6
MMC1_DAT7
OSC0_IN
OSC0_OUT
OSC1_IN
OSC1_OUT
PROC_A15
SYS_RESETn
TIMER4
TIMER5
TIMER6
TIMER7
U5_R13
U5_T13
UART4_RXD
UART4_TXD
USB1_OCn
USR0
USR1
USR2
USR3
XDMA_EVENT_INTR0
