mrpackethead/bbb_eagle/BeagleBone_Black_egl.brd

## EAGLE design BeagleBone_Black_egl.brd (continued)

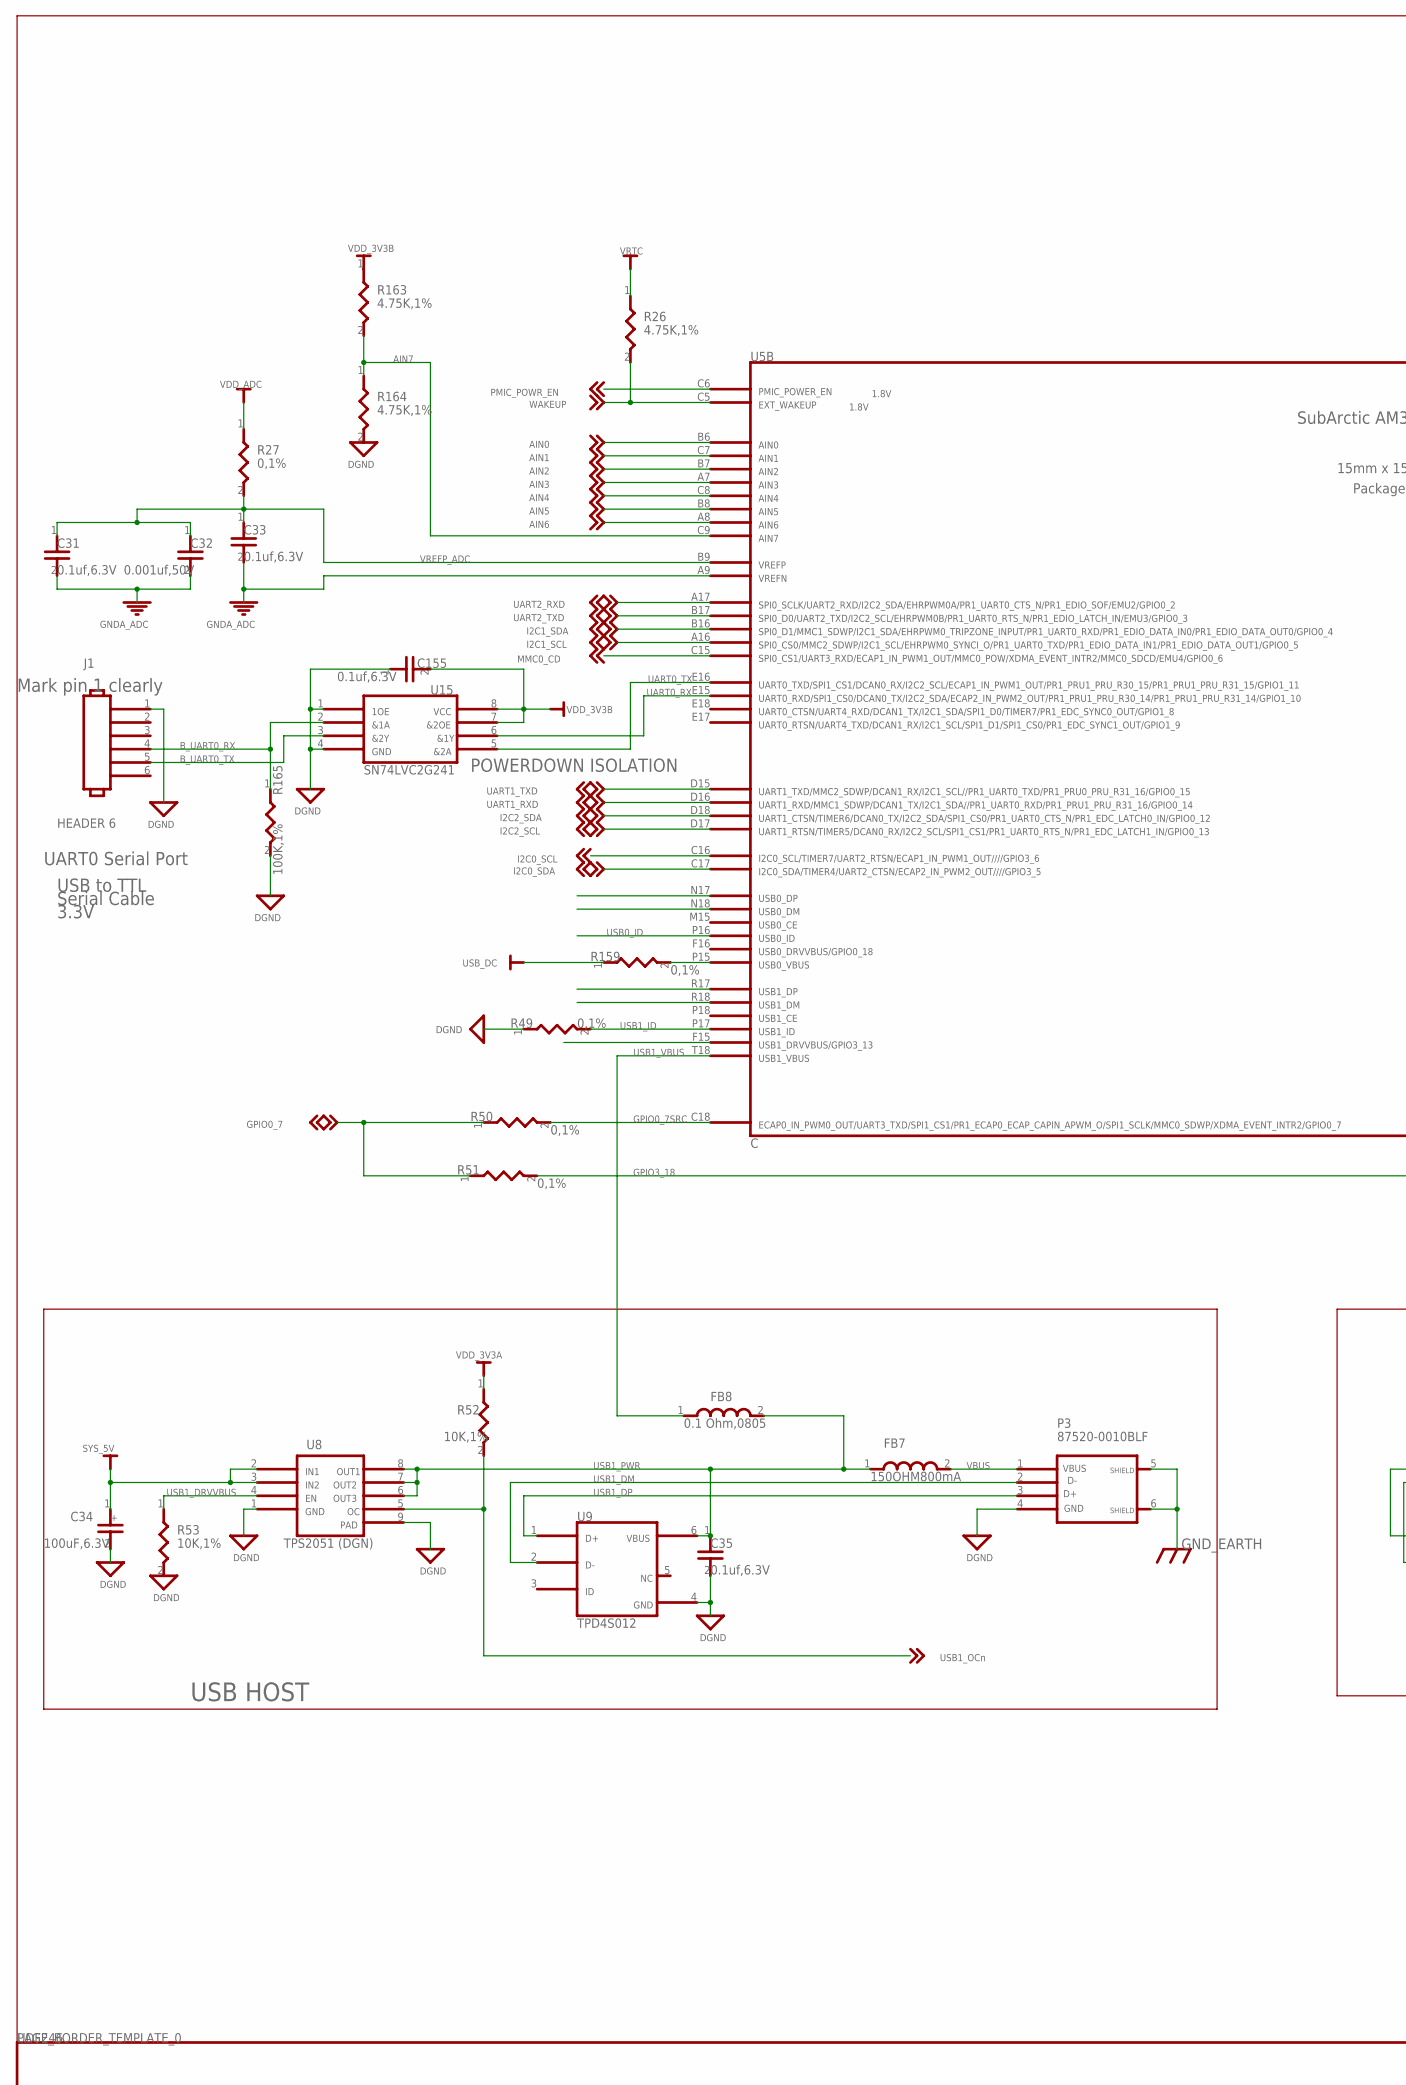
[picture p5: schematic BeagleBone_Black_egl.sch, sheet 4, part in row 1, column 1]

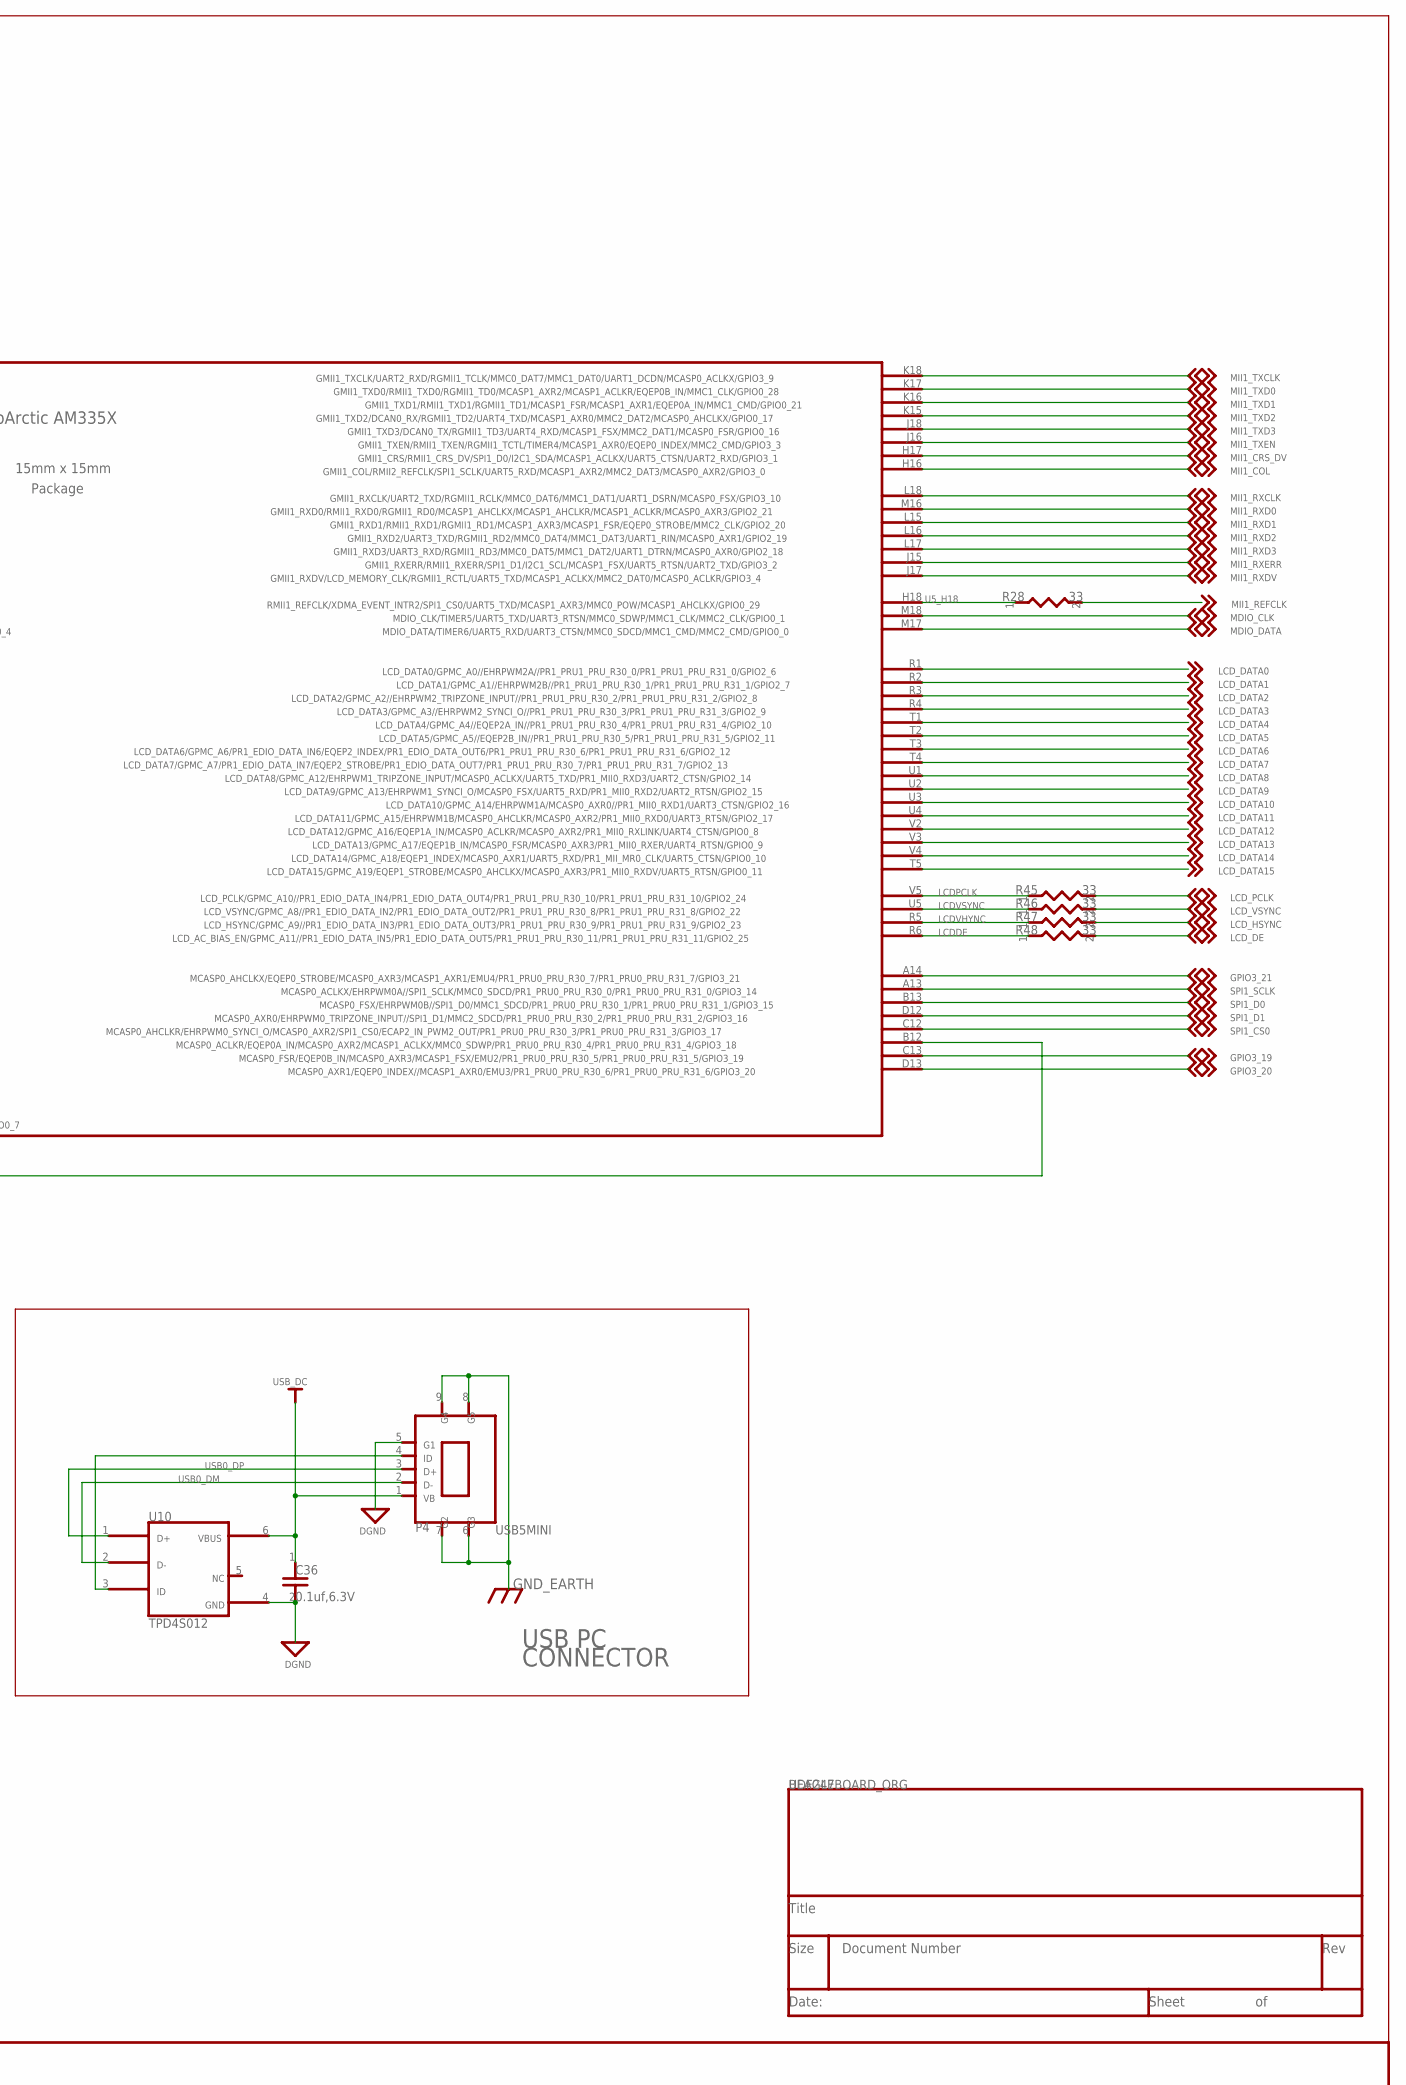
[picture p6: schematic BeagleBone_Black_egl.sch, sheet 4, part in row 1, column 2]

Parts:
C31, C33, C35, C36, C155: 0.1uf,6.3V; 402
C32: 0.001uf,50V; 402
C34: 100uF,6.3V; RD205SMD_250D
FB7: 150OHM800mA; SM-7351-IND-0805
FB8: 0.1 Ohm,0805; SM-7351-IND-0805
J1: HEADER 6; SIP6
P3: 87520-0010BLF; USB_A_SH
P4: USB5MINI; USB5MINI_4SHIELDED_SMD-5
R26, R163, R164: 4.75K,1%; 402
R27, R49, R50, R51, R159: 0,1%; 402
R28, R45, R46, R47, R48: 33; 0402
R52, R53: 10K,1%; 402
R165: 100K,1%; 402
U5: C; AM33XX_15X15
U8: TPS2051 (DGN); DGN-16X60
U9, U10: TPD4S012; U_6_DRY
U15: SN74LVC2G241; U_8_DCU

Connections:
AIN0: U5.B6 (1); also elsewhere on the board
AIN1: U5.C7 (2); also elsewhere on the board
AIN2: U5.B7 (3); also elsewhere on the board
AIN3: U5.A7 (4); also elsewhere on the board
AIN4: U5.C8 (5); also elsewhere on the board
AIN5: U5.B8 (6); also elsewhere on the board
AIN6: U5.A8 (7); also elsewhere on the board
AIN7: R163.2, R164.1, U5.C9 (8)
B_UART0_RX: J1.4, R165.1, U15.2 (1)
B_UART0_TX: J1.5, U15.3 (7)
DGND: C34.2, C35.2, C36.2, C155.1, J1.1, P3.4, P4.5 (7), R49.1, R53.2, R164.2, R165.2, U8.1, U8.9, U9.4, U10.4, U15.1 (3), U15.4 (5); also elsewhere on the board
GNDA_ADC: C31.2, C32.2, C33.2, U5.A9 (10); also elsewhere on the board
GND_EARTH: P3.5, P3.6, P4.6, P4.7 (5), P4.8, P4.9; also elsewhere on the board
GPIO0_7: R50.1, R51.1; also elsewhere on the board
GPIO0_7SRC: R50.2, U5.C18 (86)
GPIO3_18: R51.2, U5.B12 (83)
GPIO3_19: U5.C13 (84); also elsewhere on the board
GPIO3_20: U5.D13 (85); also elsewhere on the board
GPIO3_21: U5.A14 (78); also elsewhere on the board
I2C0_SCL: U5.C16 (49); also elsewhere on the board
I2C0_SDA: U5.C17 (50); also elsewhere on the board
I2C1_SCL: U5.A16 (74); also elsewhere on the board
I2C1_SDA: U5.B16 (73); also elsewhere on the board
I2C2_SCL: U5.D17 (48); also elsewhere on the board
I2C2_SDA: U5.D18 (47); also elsewhere on the board
LCDDE: R48.1, U5.R6 (70)
LCDPCLK: R45.1, U5.V5 (67)
LCDVHYNC: R47.1, U5.R5 (69)
LCDVSYNC: R46.1, U5.U5 (68)
LCD_DATA0: U5.R1 (51); also elsewhere on the board
LCD_DATA1: U5.R2 (52); also elsewhere on the board
LCD_DATA2: U5.R3 (53); also elsewhere on the board
LCD_DATA3: U5.R4 (54); also elsewhere on the board
LCD_DATA4: U5.T1 (55); also elsewhere on the board
LCD_DATA5: U5.T2 (56); also elsewhere on the board
LCD_DATA6: U5.T3 (57); also elsewhere on the board
LCD_DATA7: U5.T4 (58); also elsewhere on the board
LCD_DATA8: U5.U1 (59); also elsewhere on the board
LCD_DATA9: U5.U2 (60); also elsewhere on the board
LCD_DATA10: U5.U3 (61); also elsewhere on the board
LCD_DATA11: U5.U4 (62); also elsewhere on the board
LCD_DATA12: U5.V2 (63); also elsewhere on the board
LCD_DATA13: U5.V3 (64); also elsewhere on the board
LCD_DATA14: U5.V4 (65); also elsewhere on the board
LCD_DATA15: U5.T5 (66); also elsewhere on the board
LCD_DE: R48.2; also elsewhere on the board
LCD_HSYNC: R47.2; also elsewhere on the board
LCD_PCLK: R45.2; also elsewhere on the board
LCD_VSYNC: R46.2; also elsewhere on the board
MDIO_CLK: U5.M18 (43); also elsewhere on the board
MDIO_DATA: U5.M17 (44); also elsewhere on the board
MII1_COL: U5.H16 (27); also elsewhere on the board
MII1_CRS_DV: U5.H17 (28); also elsewhere on the board
MII1_REFCLK: R28.2; also elsewhere on the board
MII1_RXCLK: U5.L18 (37); also elsewhere on the board
MII1_RXD0: U5.M16 (38); also elsewhere on the board
MII1_RXD1: U5.L15 (39); also elsewhere on the board
MII1_RXD2: U5.L16 (40); also elsewhere on the board
MII1_RXD3: U5.L17 (41); also elsewhere on the board
MII1_RXDV: U5.J17 (36); also elsewhere on the board
MII1_RXERR: U5.J15 (35); also elsewhere on the board
MII1_TXCLK: U5.K18 (33); also elsewhere on the board
MII1_TXD0: U5.K17 (29); also elsewhere on the board
MII1_TXD1: U5.K16 (30); also elsewhere on the board
MII1_TXD2: U5.K15 (31); also elsewhere on the board
MII1_TXD3: U5.J18 (32); also elsewhere on the board
MII1_TXEN: U5.J16 (34); also elsewhere on the board
MMC0_CD: U5.C15 (75); also elsewhere on the board
N22155575: R159.2, U5.P15 (18)
PMIC_POWR_EN: U5.C6 (76); also elsewhere on the board
SPI1_CS0: U5.C12 (82); also elsewhere on the board
SPI1_D0: U5.B13 (80); also elsewhere on the board
SPI1_D1: U5.D12 (81); also elsewhere on the board
SPI1_SCLK: U5.A13 (79); also elsewhere on the board
SYS_5V: C34.1, U8.2, U8.3; also elsewhere on the board
U5_H18: R28.1, U5.H18 (42)
UART0_RX: U5.E15 (12), U15.6 (8)
UART0_TX: U5.E16 (11), U15.5 (6)
UART1_RXD: U5.D16 (46); also elsewhere on the board
UART1_TXD: U5.D15 (45); also elsewhere on the board
UART2_RXD: U5.A17 (71); also elsewhere on the board
UART2_TXD: U5.B17 (72); also elsewhere on the board
USB0_DM: P4.2 (1), U5.N18 (16), U10.2
USB0_DP: P4.3 (2), U5.N17 (15), U10.1
USB0_ID: P4.4, U5.P16 (23), U10.3 (6)
USB1_DM: P3.2 (3), U5.R18 (21), U9.2
USB1_DP: P3.3 (2), U5.R17 (20), U9.1
USB1_DRVVBUS: R53.1, U5.F15 (26), U8.4
USB1_ID: R49.2, U5.P17 (22)
USB1_OCN: R52.2, U8.5 (8); also elsewhere on the board
USB1_PWR: C35.1, FB7.1, FB8.2, U8.6 (5), U8.7 (6), U8.8 (7), U9.6 (3)
USB1_VBUS: FB8.1, U5.T18 (25)
USB_DC: C36.1, P4.1 (3), R159.1, U10.6 (3); also elsewhere on the board
VBUS: FB7.2, P3.1
VDD_3V3A: R52.1; also elsewhere on the board
VDD_3V3B: C155.2, R163.1, U15.7 (2), U15.8 (4); also elsewhere on the board
VDD_ADC: R27.1; also elsewhere on the board
VREFP_ADC: C31.1, C32.1, C33.1, R27.2, U5.B9 (9)
VRTC: R26.1; also elsewhere on the board
WAKEUP: R26.2, U5.C5 (77); also elsewhere on the board

Notes on the sheet:
USB HOST
USB PC
CONNECTOR
UART0 Serial Port
USB to TTL
Serial Cable
3.3V
Mark pin 1 clearly
POWERDOWN ISOLATION
DGND
GND_EARTH
I2C0_SCL
I2C0_SDA
PMIC_POWR_EN
SYS_5V
USB_DC
VDD_3V3A
VDD_3V3B
VRTC
WAKEUP
GPIO3_20
GPIO3_21
MMC0_CD
USB1_OCn
AIN0
AIN1
AIN2
AIN3
AIN4
AIN5
AIN6
AIN7
B_UART0_RX
B_UART0_TX
GNDA_ADC
GPIO0_7
GPIO0_7SRC
GPIO3_18
GPIO3_19
I2C1_SCL
I2C1_SDA
I2C2_SCL
I2C2_SDA
LCDDE
LCDPCLK
LCDVHYNC
LCDVSYNC
LCD_DATA0
LCD_DATA1
LCD_DATA10
LCD_DATA11
LCD_DATA12
LCD_DATA13
LCD_DATA14
LCD_DATA15
LCD_DATA2
LCD_DATA3
LCD_DATA4
LCD_DATA5
LCD_DATA6
LCD_DATA7
LCD_DATA8
LCD_DATA9
LCD_DE
LCD_HSYNC
LCD_PCLK
LCD_VSYNC
MDIO_CLK
MDIO_DATA
MII1_COL
MII1_CRS_DV
MII1_REFCLK
MII1_RXCLK
MII1_RXD0
MII1_RXD1
MII1_RXD2
MII1_RXD3
MII1_RXDV
MII1_RXERR
MII1_TXCLK
MII1_TXD0
MII1_TXD1
MII1_TXD2
MII1_TXD3
MII1_TXEN
SPI1_CS0
SPI1_D0
SPI1_D1
SPI1_SCLK
U5_H18
UART0_RX
UART0_TX
UART1_RXD
UART1_TXD
UART2_RXD
UART2_TXD
USB0_DM
USB0_DP
USB0_ID
USB1_DM
USB1_DP
USB1_DRVVBUS
USB1_ID
USB1_PWR
USB1_VBUS
VBUS
VDD_ADC
VREFP_ADC

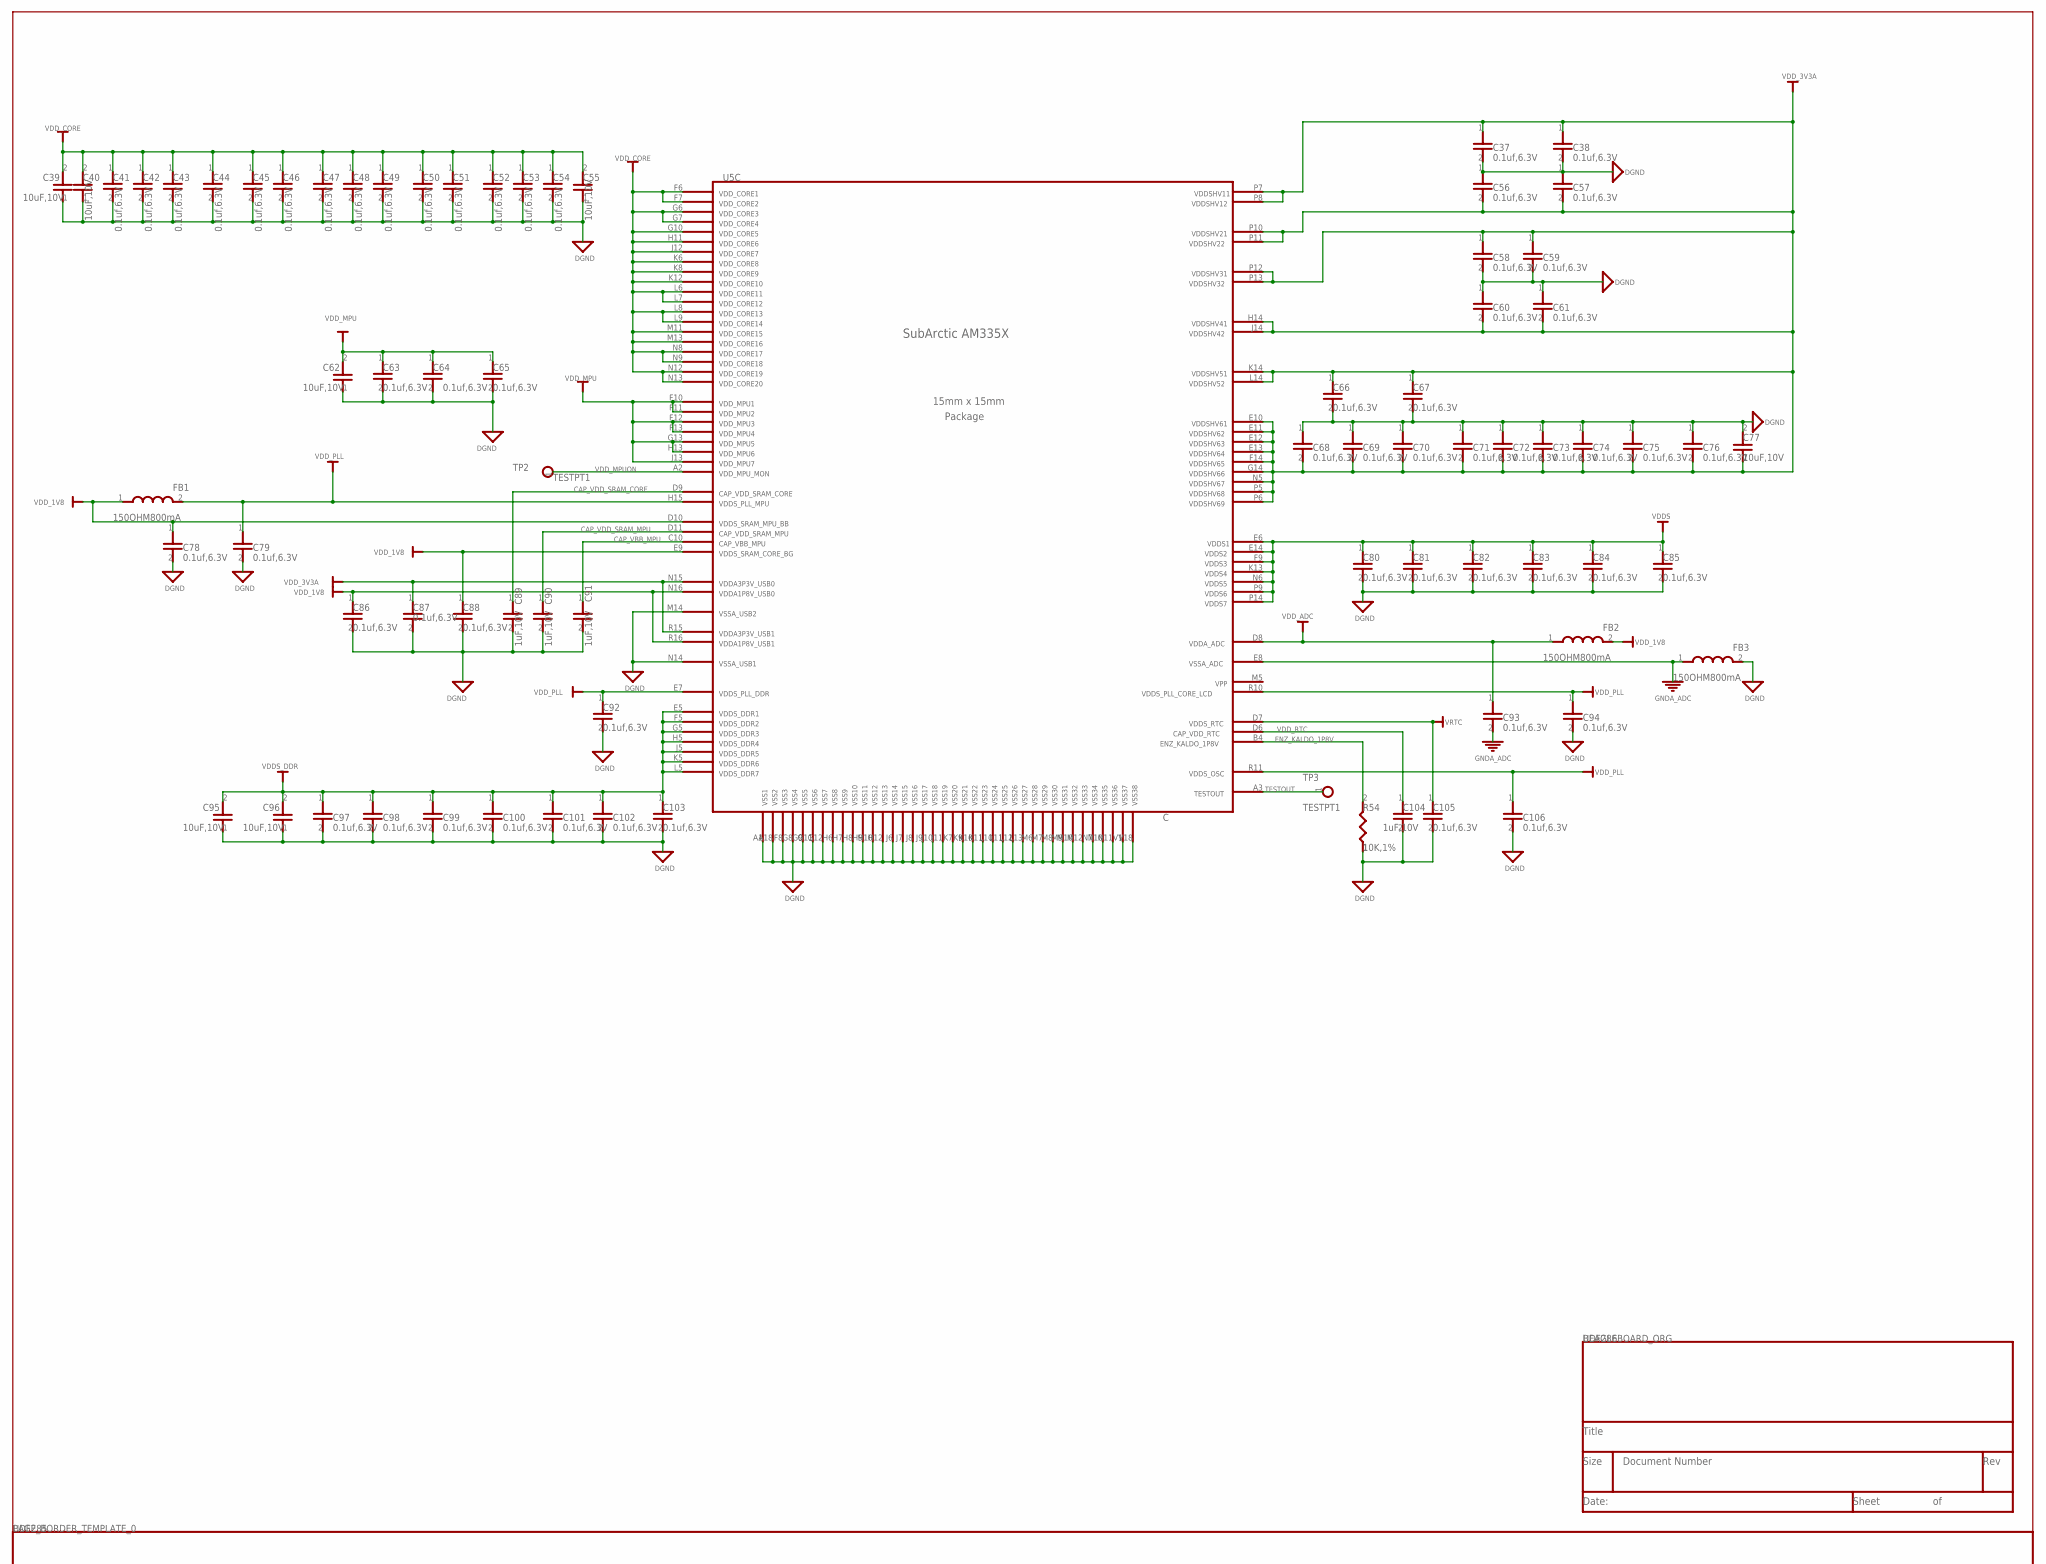
[picture p7: schematic BeagleBone_Black_egl.sch, sheet 5, part in row 1, column 1]

Parts:
C37, C38, C41, C42, C43, C44, C45, C46, C47, C48, C49, C50, C51, C52, C53, C54, C56, C57, C58, C59, C60, C61, C63, C64, C65, C66, C67, C68, C69, C70, C71, C72, C73, C74, C75, C76, C78, C79, C80, C81, C82, C83, C84, C85, C86, C87, C88, C92, C93, C94, C97, C98, C99, C100, C101, C102, C103, C105, C106: 0.1uf,6.3V; 402
C39, C40, C55, C62, C77, C95, C96: 10uF,10V; 805
C89, C90, C91, C104: 1uF,10V; 402
FB1, FB2, FB3: 150OHM800mA; SM-7351-IND-0805
R54: 10K,1%; 402
TP2, TP3: TESTPT1; TP60C_SMD
U5: C; AM33XX_15X15

Connections:
CAP_VBB_MPU: C91.1, U5.C10 (76)
CAP_VDD_SRAM_CORE: C89.1, U5.D9 (68)
CAP_VDD_SRAM_MPU: C90.1, U5.D11 (77)
DGND: C37.2, C38.2, C39.1, C40.1, C41.2, C42.2, C43.2, C44.2, C45.2, C46.2, C47.2, C48.2, C49.2, C50.2, C51.2, C52.2, C53.2, C54.2, C55.1, C56.1, C57.1, C58.2, C59.2, C60.1, C61.1, C62.1, C63.2, C64.2, C65.2, C66.2, C67.2, C68.1, C69.1, C70.1, C71.1, C72.1, C73.1, C74.1, C75.1, C76.1, C77.2, C78.2, C79.2, C80.2, C81.2, C82.2, C83.2, C84.2, C85.2, C86.2, C87.2, C88.2, C89.2, C90.2, C91.2, C92.2, C94.2, C95.1, C96.1, C97.2, C98.2, C99.2, C100.2, C101.2, C102.2, C103.2, C104.2, C105.2, C106.2, FB3.2, R54.1, U5.A1 (1), U5.A18 (2), U5.F8 (4), U5.G8 (6), U5.G9 (5), U5.G11 (14), U5.G12 (101), U5.H6 (7), U5.H7 (16), U5.H8 (18), U5.H9 (8), U5.H10 (9), U5.H12 (15), U5.J6 (24), U5.J7 (10), U5.J8 (11), U5.J9 (12), U5.J10 (13), U5.J11 (27), U5.K7 (17), U5.K9 (19), U5.K10 (20), U5.K11 (21), U5.L10 (35), U5.L11 (23), U5.L12 (29), U5.L13 (36), U5.M6 (25), U5.M7 (26), U5.M8 (3), U5.M9 (28), U5.M10 (30), U5.M12 (22), U5.M14 (85), U5.N7 (31), U5.N10 (33), U5.N11 (34), U5.N14 (82), U5.V1 (37), U5.V18 (32); also elsewhere on the board
ENZ_KALDO_1P8V: R54.2, U5.B4 (99)
GNDA_ADC: C93.2, FB3.1, U5.E8 (87); also elsewhere on the board
TESTOUT: TP3.1, U5.A3 (100)
VDDS: C80.1, C81.1, C82.1, C83.1, C84.1, C85.1, U5.E6 (62), U5.E14 (63), U5.F9 (64), U5.K13 (65), U5.N6 (66), U5.P9 (67), U5.P14 (120); also elsewhere on the board
VDDS_DDR: C95.2, C96.2, C97.1, C98.1, C99.1, C100.1, C101.1, C102.1, C103.1, U5.E5 (90), U5.F5 (91), U5.G5 (92), U5.H5 (93), U5.J5 (89), U5.K5 (94), U5.L5 (95); also elsewhere on the board
VDD_1V8: C78.1, C86.1, C88.1, FB1.1, FB2.2, U5.D10 (75), U5.E9 (69), U5.N16 (84), U5.R16 (81); also elsewhere on the board
VDD_3V3A: C37.1, C38.1, C56.2, C57.2, C58.1, C59.1, C60.2, C61.2, C66.1, C67.1, C68.2, C69.2, C70.2, C71.2, C72.2, C73.2, C74.2, C75.2, C76.2, C77.1, C87.1, U5.E10 (111), U5.E11 (112), U5.E12 (113), U5.E13 (114), U5.F14 (115), U5.G14 (116), U5.H14 (59), U5.J14 (58), U5.K14 (60), U5.L14 (61), U5.N5 (117), U5.N15 (83), U5.P5 (118), U5.P6 (119), U5.P7 (53), U5.P8 (54), U5.P10 (55), U5.P11 (96), U5.P12 (56), U5.P13 (57), U5.R15 (80); also elsewhere on the board
VDD_ADC: C93.1, FB2.1, U5.D8 (72); also elsewhere on the board
VDD_CORE: C39.2, C40.2, C41.1, C42.1, C43.1, C44.1, C45.1, C46.1, C47.1, C48.1, C49.1, C50.1, C51.1, C52.1, C53.1, C54.1, C55.2, U5.F6 (38), U5.F7 (39), U5.G6 (40), U5.G7 (42), U5.G10 (43), U5.H11 (45), U5.J12 (46), U5.K6 (47), U5.K8 (97), U5.K12 (49), U5.L6 (50), U5.L7 (51), U5.L8 (52), U5.L9 (98), U5.M11 (102), U5.M13 (103), U5.N8 (104), U5.N9 (105), U5.N12 (106), U5.N13 (107); also elsewhere on the board
VDD_MPU: C62.2, C63.1, C64.1, C65.1, U5.F10 (41), U5.F11 (44), U5.F12 (48), U5.F13 (88), U5.G13 (108), U5.H13 (109), U5.J13 (110); also elsewhere on the board
VDD_MPUON: TP2.1, U5.A2 (121)
VDD_PLL: C79.1, C92.1, C94.1, C106.1, FB1.2, U5.E7 (86), U5.H15 (79), U5.R10 (71), U5.R11 (70)
VDD_RTC: C104.1, U5.D6 (73)
VRTC: C105.1, U5.D7 (74); also elsewhere on the board

Notes on the sheet:
DGND
VDDS
VDDS_DDR
VDD_1V8
VDD_3V3A
VDD_CORE
VDD_MPU
VRTC
GNDA_ADC
VDD_ADC
CAP_VBB_MPU
CAP_VDD_SRAM_CORE
CAP_VDD_SRAM_MPU
ENZ_KALDO_1P8V
TESTOUT
VDD_MPUON
VDD_PLL
VDD_RTC

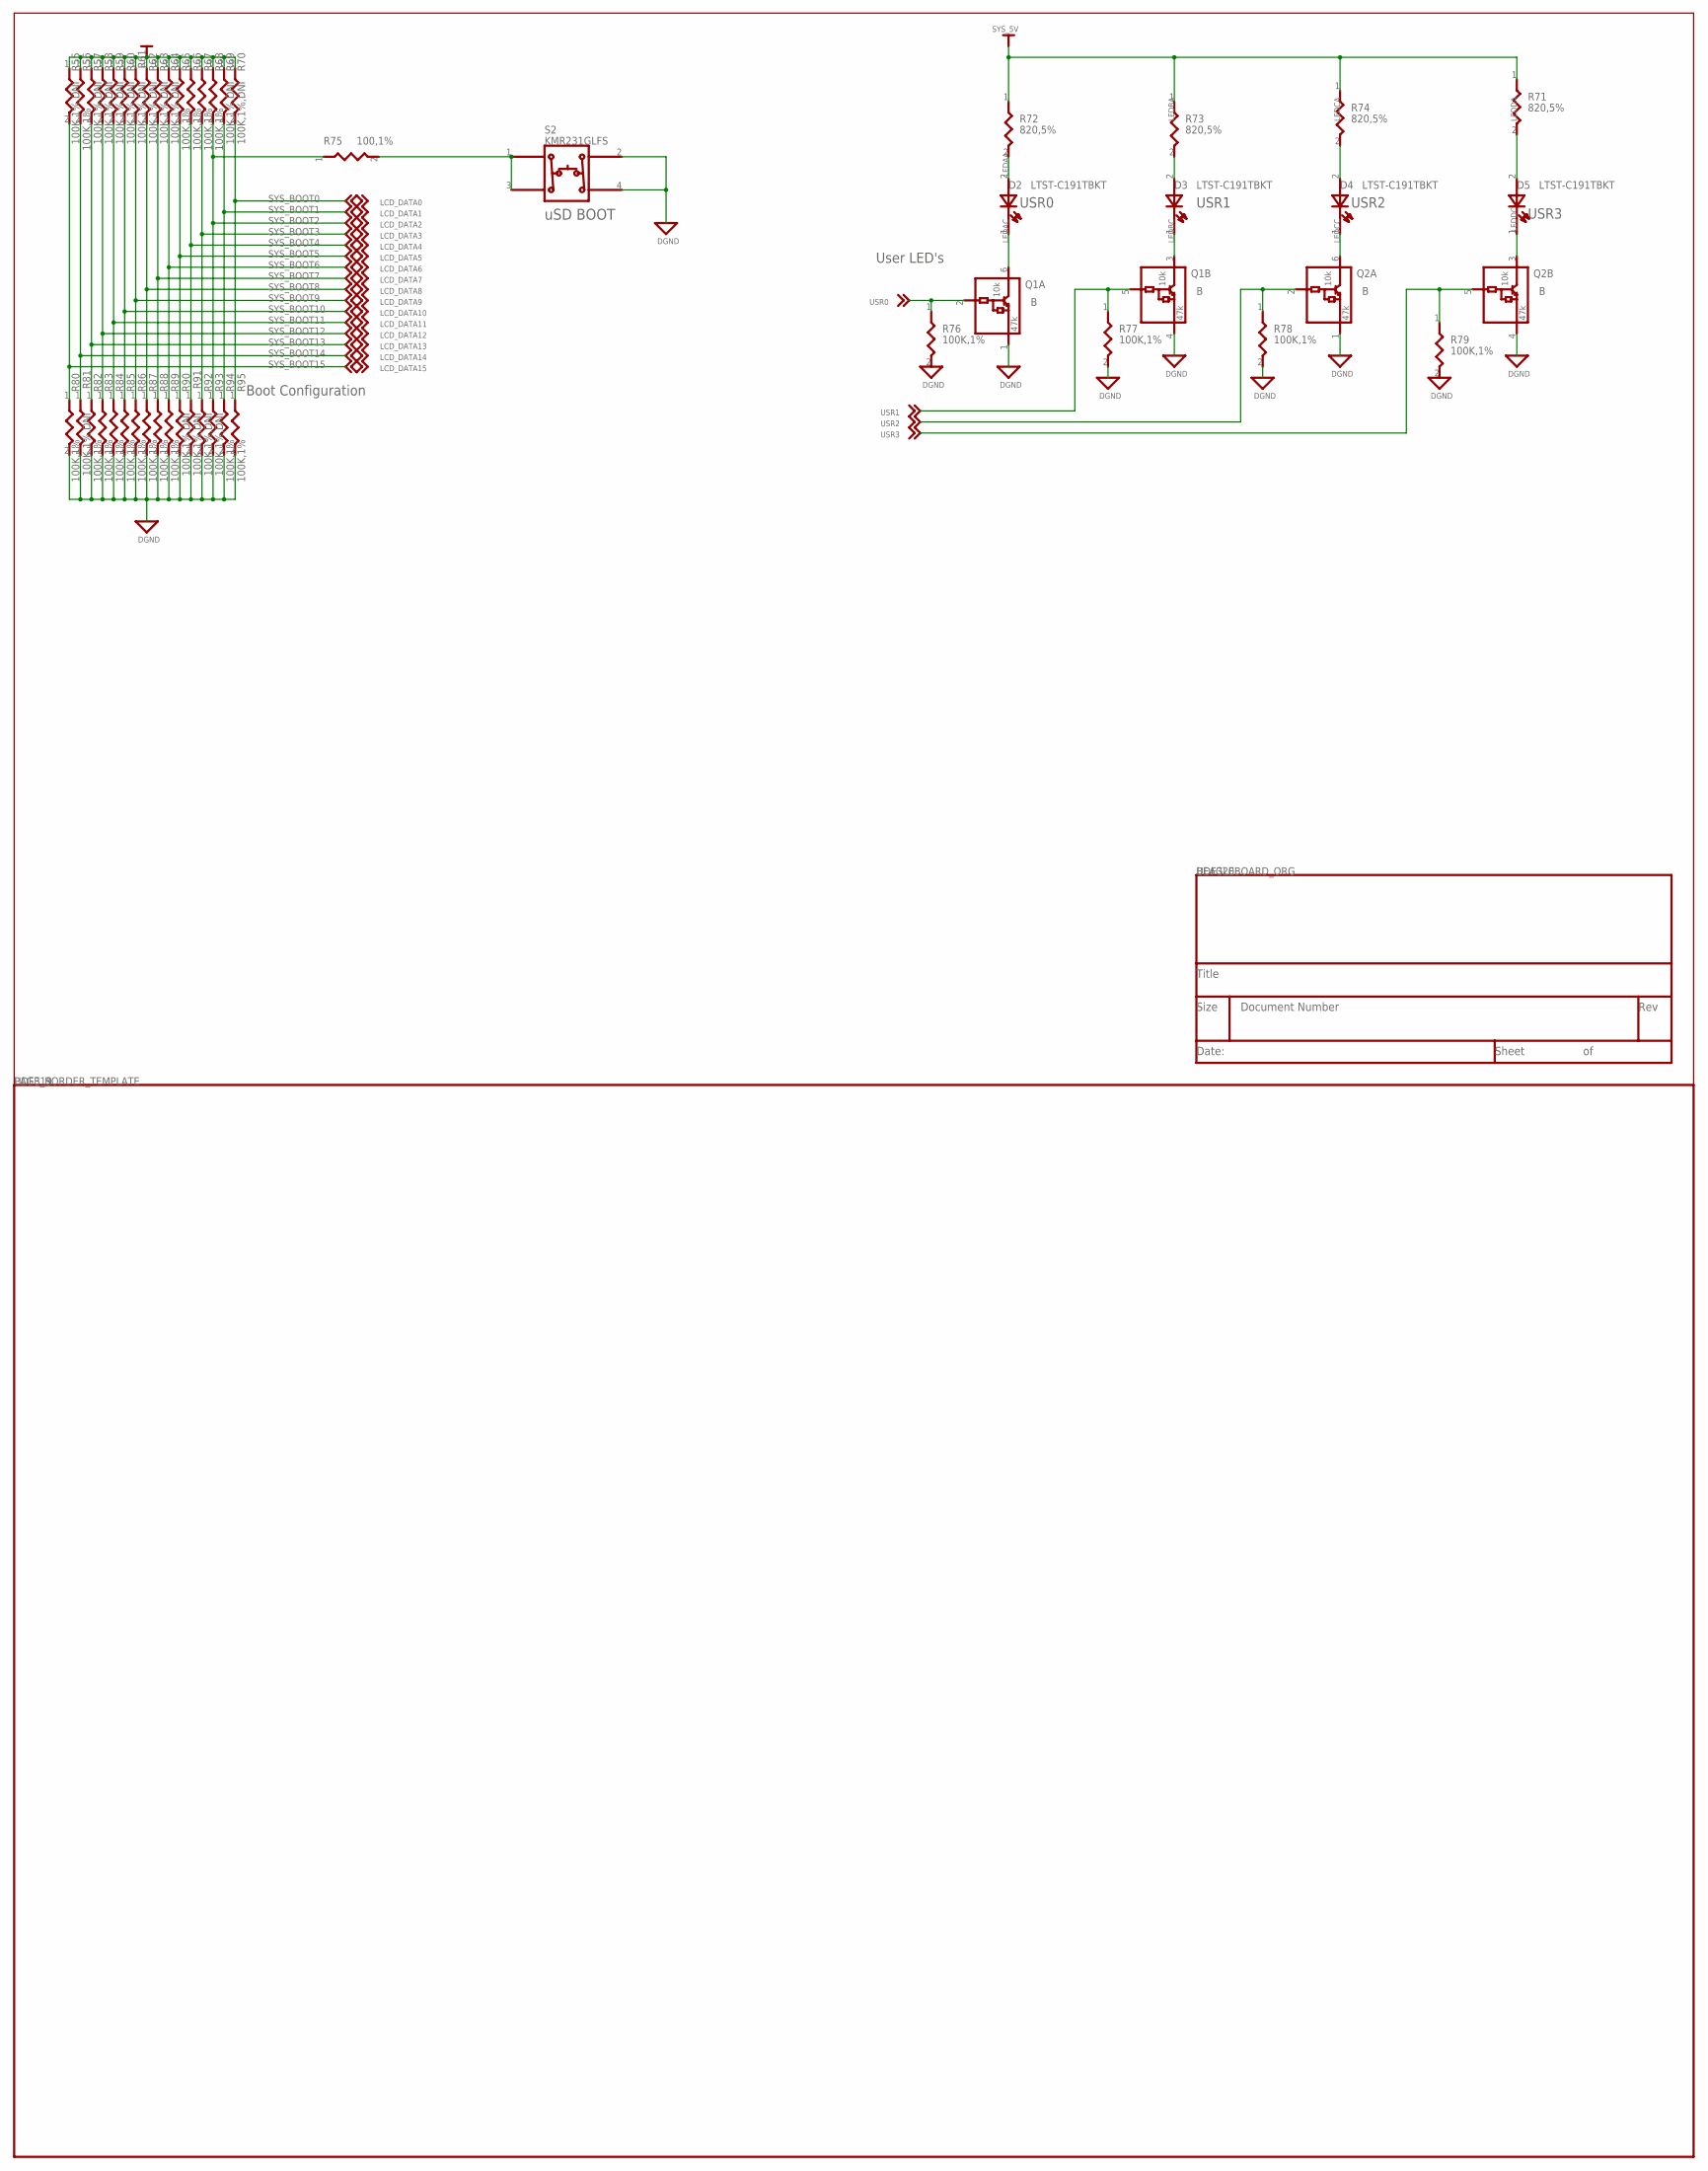
[picture p8: schematic BeagleBone_Black_egl.sch, sheet 6]

Parts:
D2, D3, D4, D5: LTST-C191TBKT; LED_0603
Q1, Q2: B; SMINI6-F3-B
R55, R57, R58, R59, R60, R61, R62, R63, R64, R69, R70, R81, R90, R91, R92, R93: 100K,1%,DNI; 402
R56, R65, R66, R67, R68, R76, R77, R78, R79, R80, R82, R83, R84, R85, R86, R87, R88, R89, R94, R95: 100K,1%; 402
R71, R72, R73, R74: 820,5%; 402
R75: 100,1%; 402
S2: KMR231GLFS; SW4SMD_63X161LS

Connections:
DGND: Q1.1, Q1.4 (1), Q2.1, Q2.4 (1), R76.2, R77.2, R78.2, R79.2, R80.2, R81.2, R82.2, R83.2, R84.2, R85.2, R86.2, R87.2, R88.2, R89.2, R90.2, R91.2, R92.2, R93.2, R94.2, R95.2, S2.2, S2.4; also elsewhere on the board
LCD_DATA0: R70.2, R95.1; also elsewhere on the board
LCD_DATA1: R69.2, R94.1; also elsewhere on the board
LCD_DATA2: R68.2, R75.1, R93.1; also elsewhere on the board
LCD_DATA3: R67.2, R92.1; also elsewhere on the board
LCD_DATA4: R66.2, R91.1; also elsewhere on the board
LCD_DATA5: R65.2, R90.1; also elsewhere on the board
LCD_DATA6: R64.2, R89.1; also elsewhere on the board
LCD_DATA7: R63.2, R88.1; also elsewhere on the board
LCD_DATA8: R62.2, R87.1; also elsewhere on the board
LCD_DATA9: R61.2, R86.1; also elsewhere on the board
LCD_DATA10: R60.2, R85.1; also elsewhere on the board
LCD_DATA11: R59.2, R84.1; also elsewhere on the board
LCD_DATA12: R58.2, R83.1; also elsewhere on the board
LCD_DATA13: R57.2, R82.1; also elsewhere on the board
LCD_DATA14: R56.2, R81.1; also elsewhere on the board
LCD_DATA15: R55.2, R80.1; also elsewhere on the board
LEDAA: D2.2, R72.2
LEDAC: D2.1, Q1.6 (2)
LEDBA: D3.2, R73.2
LEDBC: D3.1, Q1.3 (2)
LEDCA: D4.2, R74.2
LEDCC: D4.1, Q2.6 (2)
LEDDA: D5.2, R71.2
LEDDC: D5.1, Q2.3 (2)
N21769115: R75.2, S2.1, S2.3
SYS_5V: R71.1, R72.1, R73.1, R74.1; also elsewhere on the board
USR0: Q1.2 (3), R76.1; also elsewhere on the board
USR1: Q1.5 (3), R77.1; also elsewhere on the board
USR2: Q2.2 (3), R78.1; also elsewhere on the board
USR3: Q2.5 (3), R79.1; also elsewhere on the board
VDD_3V3A: R55.1, R56.1, R57.1, R58.1, R59.1, R60.1, R61.1, R62.1, R63.1, R64.1, R65.1, R66.1, R67.1, R68.1, R69.1, R70.1; also elsewhere on the board

Notes on the sheet:
SYS_BOOT8
SYS_BOOT9
SYS_BOOT10
SYS_BOOT11
SYS_BOOT12
SYS_BOOT13
SYS_BOOT14
SYS_BOOT15
SYS_BOOT4
User LED's
Boot Configuration
SYS_BOOT0
SYS_BOOT1
SYS_BOOT2
SYS_BOOT3
SYS_BOOT5
SYS_BOOT6
SYS_BOOT7
USR0
USR1
USR2
USR3
uSD BOOT
DGND
SYS_5V
USR0
USR1
USR2
USR3
LCD_DATA0
LCD_DATA1
LCD_DATA10
LCD_DATA11
LCD_DATA12
LCD_DATA13
LCD_DATA14
LCD_DATA15
LCD_DATA2
LCD_DATA3
LCD_DATA4
LCD_DATA5
LCD_DATA6
LCD_DATA7
LCD_DATA8
LCD_DATA9
LEDAA
LEDAC
LEDBA
LEDBC
LEDCA
LEDCC
LEDDA
LEDDC
