mrpackethead/bbb_eagle/BeagleBone_Black_egl.brd

## EAGLE design BeagleBone_Black_egl.brd (continued)

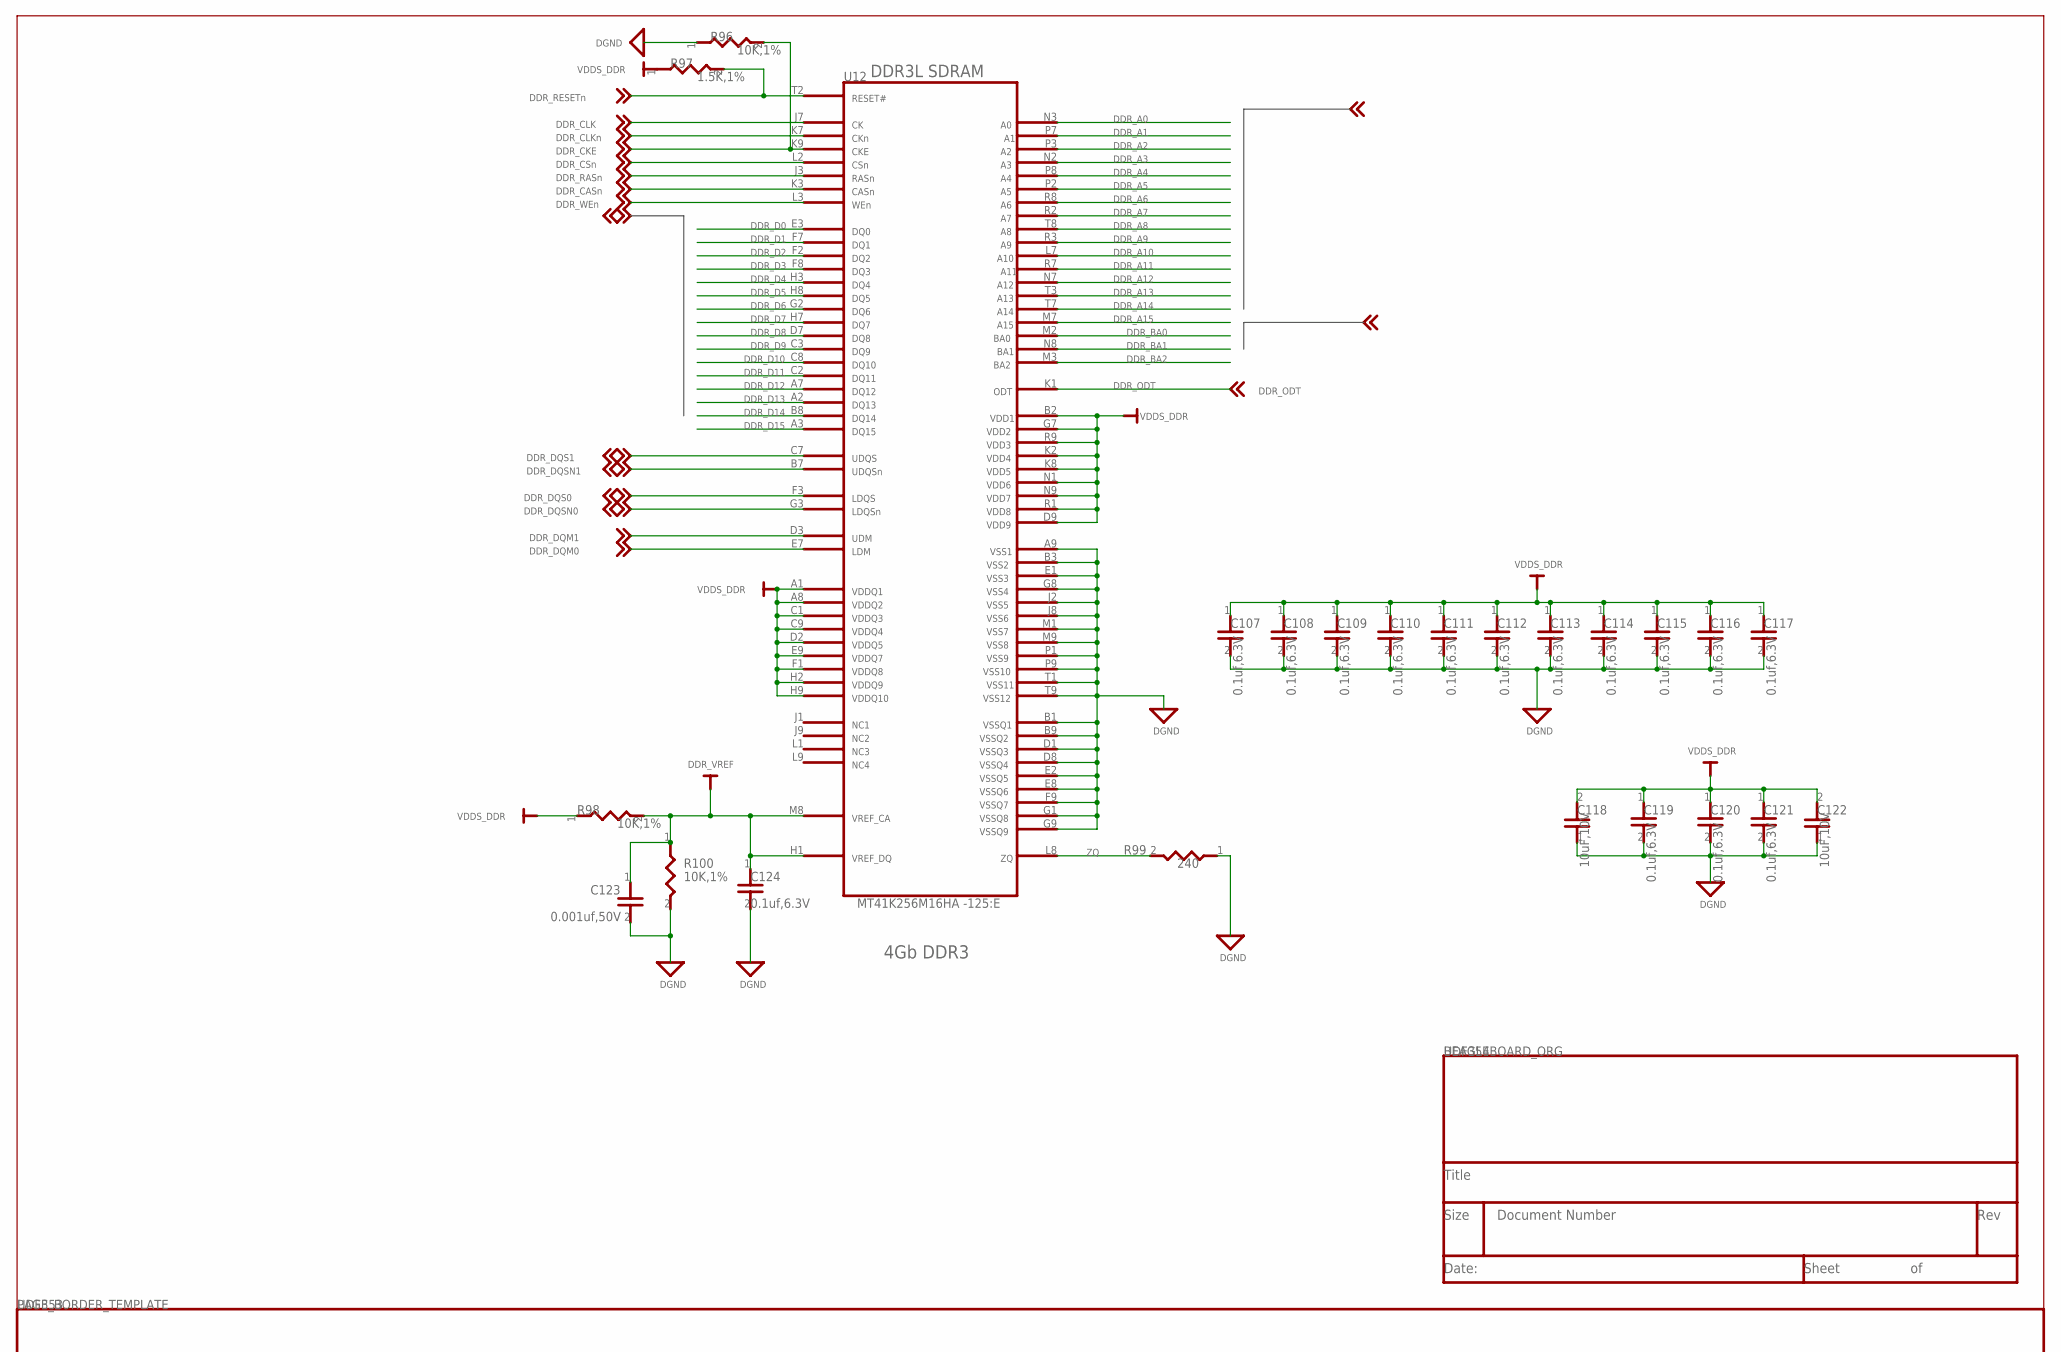
[picture p9: schematic BeagleBone_Black_egl.sch, sheet 7, part in row 1, column 1]

Parts:
C107, C108, C109, C110, C111, C112, C113, C114, C115, C116, C117, C119, C120, C121, C124: 0.1uf,6.3V; 402
C118, C122: 10uF,10V; 805
C123: 0.001uf,50V; 402
R96, R98, R100: 10K,1%; 402
R97: 1.5K,1%; 402
R99: 240; SM-7351-RES-0402
U12: MT41K256M16HA -125:E; BGA96_T9_P8_9X14

Connections:
DDR_A0: U12.N3 (8); also elsewhere on the board
DDR_A1: U12.P7 (9); also elsewhere on the board
DDR_A2: U12.P3 (10); also elsewhere on the board
DDR_A3: U12.N2 (11); also elsewhere on the board
DDR_A4: U12.P8 (12); also elsewhere on the board
DDR_A5: U12.P2 (13); also elsewhere on the board
DDR_A6: U12.R8 (14); also elsewhere on the board
DDR_A7: U12.R2 (15); also elsewhere on the board
DDR_A8: U12.T8 (16); also elsewhere on the board
DDR_A9: U12.R3 (17); also elsewhere on the board
DDR_A10: U12.L7 (18); also elsewhere on the board
DDR_A11: U12.R7 (19); also elsewhere on the board
DDR_A12: U12.N7 (20); also elsewhere on the board
DDR_A13: U12.T3 (21); also elsewhere on the board
DDR_A14: U12.T7 (22); also elsewhere on the board
DDR_A15: U12.M7 (84); also elsewhere on the board
DDR_BA0: U12.M2 (23); also elsewhere on the board
DDR_BA1: U12.N8 (24); also elsewhere on the board
DDR_BA2: U12.M3 (25); also elsewhere on the board
DDR_CASN: U12.K3 (6); also elsewhere on the board
DDR_CKE: R96.2, U12.K9 (3); also elsewhere on the board
DDR_CLK: U12.J7 (1); also elsewhere on the board
DDR_CLKN: U12.K7 (2); also elsewhere on the board
DDR_CSN: U12.L2 (4); also elsewhere on the board
DDR_D0: U12.E3 (26); also elsewhere on the board
DDR_D1: U12.F7 (27); also elsewhere on the board
DDR_D2: U12.F2 (28); also elsewhere on the board
DDR_D3: U12.F8 (29); also elsewhere on the board
DDR_D4: U12.H3 (30); also elsewhere on the board
DDR_D5: U12.H8 (31); also elsewhere on the board
DDR_D6: U12.G2 (32); also elsewhere on the board
DDR_D7: U12.H7 (33); also elsewhere on the board
DDR_D8: U12.D7 (57); also elsewhere on the board
DDR_D9: U12.C3 (96); also elsewhere on the board
DDR_D10: U12.C8 (58); also elsewhere on the board
DDR_D11: U12.C2 (59); also elsewhere on the board
DDR_D12: U12.A7 (61); also elsewhere on the board
DDR_D13: U12.A2 (63); also elsewhere on the board
DDR_D14: U12.B8 (60); also elsewhere on the board
DDR_D15: U12.A3 (62); also elsewhere on the board
DDR_DQM0: U12.E7 (53); also elsewhere on the board
DDR_DQM1: U12.D3 (52); also elsewhere on the board
DDR_DQS0: U12.F3 (56); also elsewhere on the board
DDR_DQS1: U12.C7 (55); also elsewhere on the board
DDR_DQSN0: U12.G3 (54); also elsewhere on the board
DDR_DQSN1: U12.B7 (51); also elsewhere on the board
DDR_ODT: U12.K1 (34); also elsewhere on the board
DDR_RASN: U12.J3 (5); also elsewhere on the board
DDR_RESETN: R97.2, U12.T2 (94); also elsewhere on the board
DDR_VREF: C123.1, C124.1, R98.2, R100.1, U12.H1 (71), U12.M8 (85); also elsewhere on the board
DDR_WEN: U12.L3 (7); also elsewhere on the board
DGND: C107.2, C108.2, C109.2, C110.2, C111.2, C112.2, C113.2, C114.2, C115.2, C116.2, C117.2, C118.1, C119.2, C120.2, C121.2, C122.1, C123.2, C124.2, R96.1, R99.1, R100.2, U12.A9 (35), U12.B1 (42), U12.B3 (36), U12.B9 (41), U12.D1 (40), U12.D8 (39), U12.E1 (37), U12.E2 (43), U12.E8 (65), U12.F9 (68), U12.G1 (69), U12.G8 (38), U12.G9 (70), U12.J2 (76), U12.J8 (77), U12.M1 (83), U12.M9 (86), U12.P1 (89), U12.P9 (90), U12.T1 (93), U12.T9 (95); also elsewhere on the board
VDDS_DDR: C107.1, C108.1, C109.1, C110.1, C111.1, C112.1, C113.1, C114.1, C115.1, C116.1, C117.1, C118.2, C119.1, C120.1, C121.1, C122.2, R97.1, R98.1, U12.A1 (44), U12.A8 (45), U12.B2 (49), U12.C1 (46), U12.C9 (47), U12.D2 (48), U12.D9 (64), U12.E9 (66), U12.F1 (67), U12.G7 (50), U12.H2 (72), U12.H9 (73), U12.K2 (78), U12.K8 (79), U12.N1 (87), U12.N9 (88), U12.R1 (91), U12.R9 (92); also elsewhere on the board
ZQ: R99.2, U12.L8 (81)

Notes on the sheet:
DDR3L SDRAM
4Gb DDR3
DGND
VDDS_DDR
DDR_A0
DDR_A1
DDR_A10
DDR_A11
DDR_A12
DDR_A13
DDR_A14
DDR_A15
DDR_A2
DDR_A3
DDR_A4
DDR_A5
DDR_A6
DDR_A7
DDR_A8
DDR_A9
DDR_BA0
DDR_BA1
DDR_BA2
DDR_CASn
DDR_CKE
DDR_CLK
DDR_CLKn
DDR_CSn
DDR_D0
DDR_D1
DDR_D10
DDR_D11
DDR_D12
DDR_D13
DDR_D14
DDR_D15
DDR_D2
DDR_D3
DDR_D4
DDR_D5
DDR_D6
DDR_D7
DDR_D8
DDR_D9
DDR_DQM0
DDR_DQM1
DDR_DQS0
DDR_DQS1
DDR_DQSN0
DDR_DQSN1
DDR_ODT
DDR_RASn
DDR_RESETn
DDR_VREF
DDR_WEn

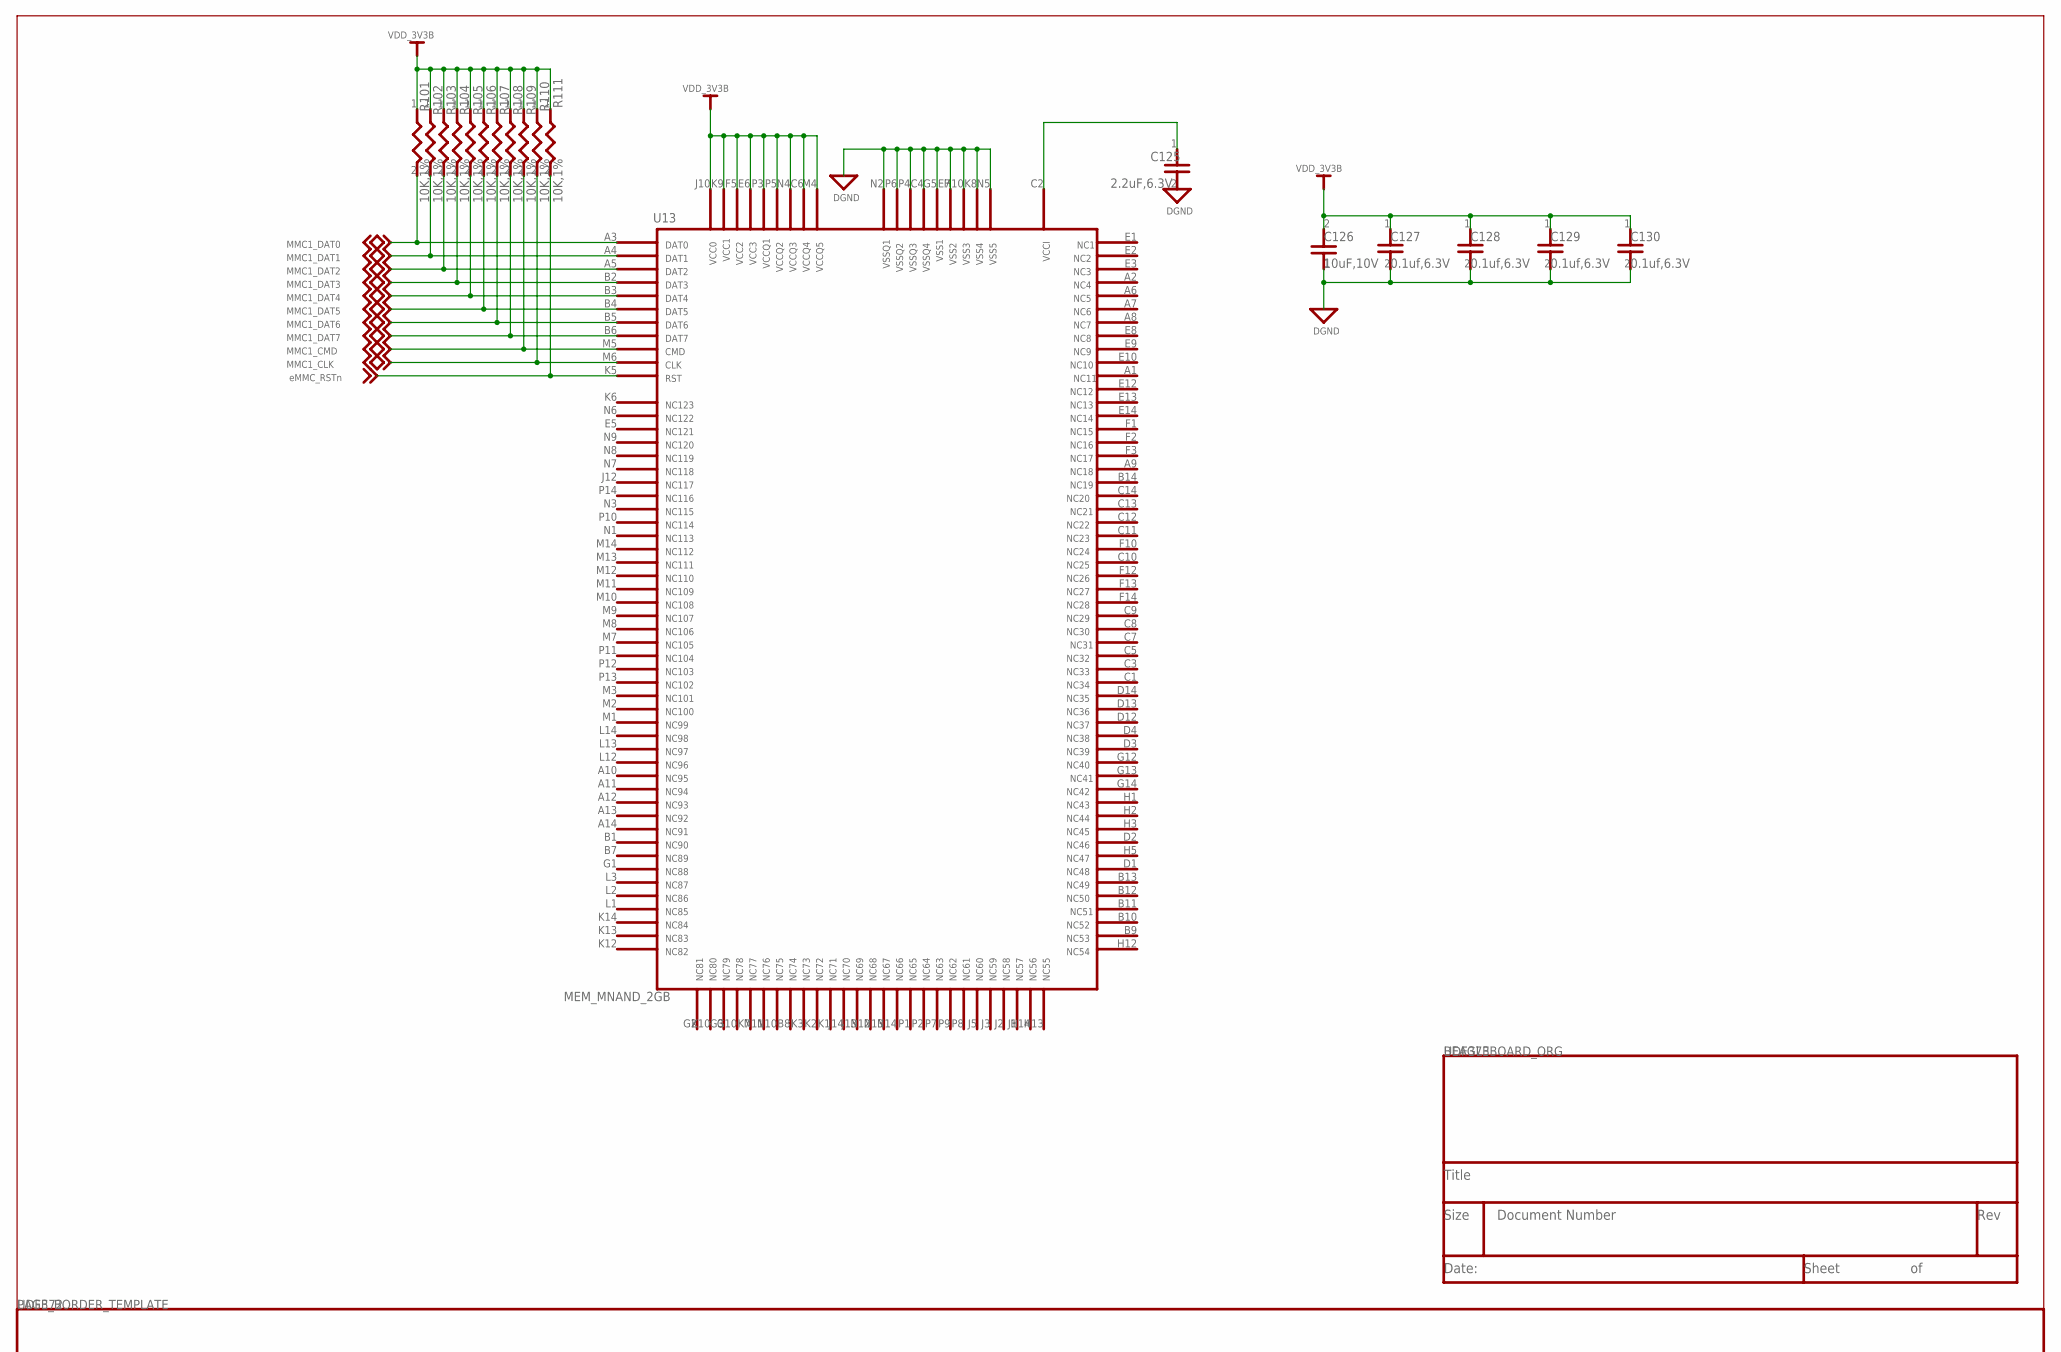
[picture p10: schematic BeagleBone_Black_egl.sch, sheet 8, part in row 1, column 1]

Parts:
C125: 2.2uF,6.3V; 402
C126: 10uF,10V; 805
C127, C128, C129, C130: 0.1uf,6.3V; 402
R101, R102, R103, R104, R105, R106, R107, R108, R109, R110, R111: 10K,1%; 402
U13: MEM_MNAND_2GB; BGA153_P14_P5_11P5X13

Connections:
DGND: C125.2, C126.1, C127.2, C128.2, C129.2, C130.2, U13.C4 (32), U13.E7 (54), U13.G5 (72), U13.H10 (81), U13.K8 (96), U13.N2 (123), U13.N5 (55), U13.P4 (138), U13.P6 (140); also elsewhere on the board
EMMC_RSTN: R111.2, U13.K5 (149); also elsewhere on the board
EMMC_VCCI: C125.1, U13.C2 (30)
MMC1_CLK: R110.2, U13.M6 (113); also elsewhere on the board
MMC1_CMD: R109.2, U13.M5 (112); also elsewhere on the board
MMC1_DAT0: R101.2, U13.A3 (3); also elsewhere on the board
MMC1_DAT1: R102.2, U13.A4 (4); also elsewhere on the board
MMC1_DAT2: R103.2, U13.A5 (5); also elsewhere on the board
MMC1_DAT3: R104.2, U13.B2 (16); also elsewhere on the board
MMC1_DAT4: R105.2, U13.B3 (17); also elsewhere on the board
MMC1_DAT5: R106.2, U13.B4 (18); also elsewhere on the board
MMC1_DAT6: R107.2, U13.B5 (19); also elsewhere on the board
MMC1_DAT7: R108.2, U13.B6 (20); also elsewhere on the board
VDD_3V3B: C126.2, C127.1, C128.1, C129.1, C130.1, R101.1, R102.1, R103.1, R104.1, R105.1, R106.1, R107.1, R108.1, R109.1, R110.1, R111.1, U13.C6 (34), U13.E6 (53), U13.F5 (65), U13.J10 (150), U13.K9 (97), U13.M4 (111), U13.N4 (125), U13.P3 (137), U13.P5 (139); also elsewhere on the board

Notes on the sheet:
DGND
VDD_3V3B
eMMC_RSTn
MMC1_CLK
MMC1_CMD
MMC1_DAT0
MMC1_DAT1
MMC1_DAT2
MMC1_DAT3
MMC1_DAT4
MMC1_DAT5
MMC1_DAT6
MMC1_DAT7

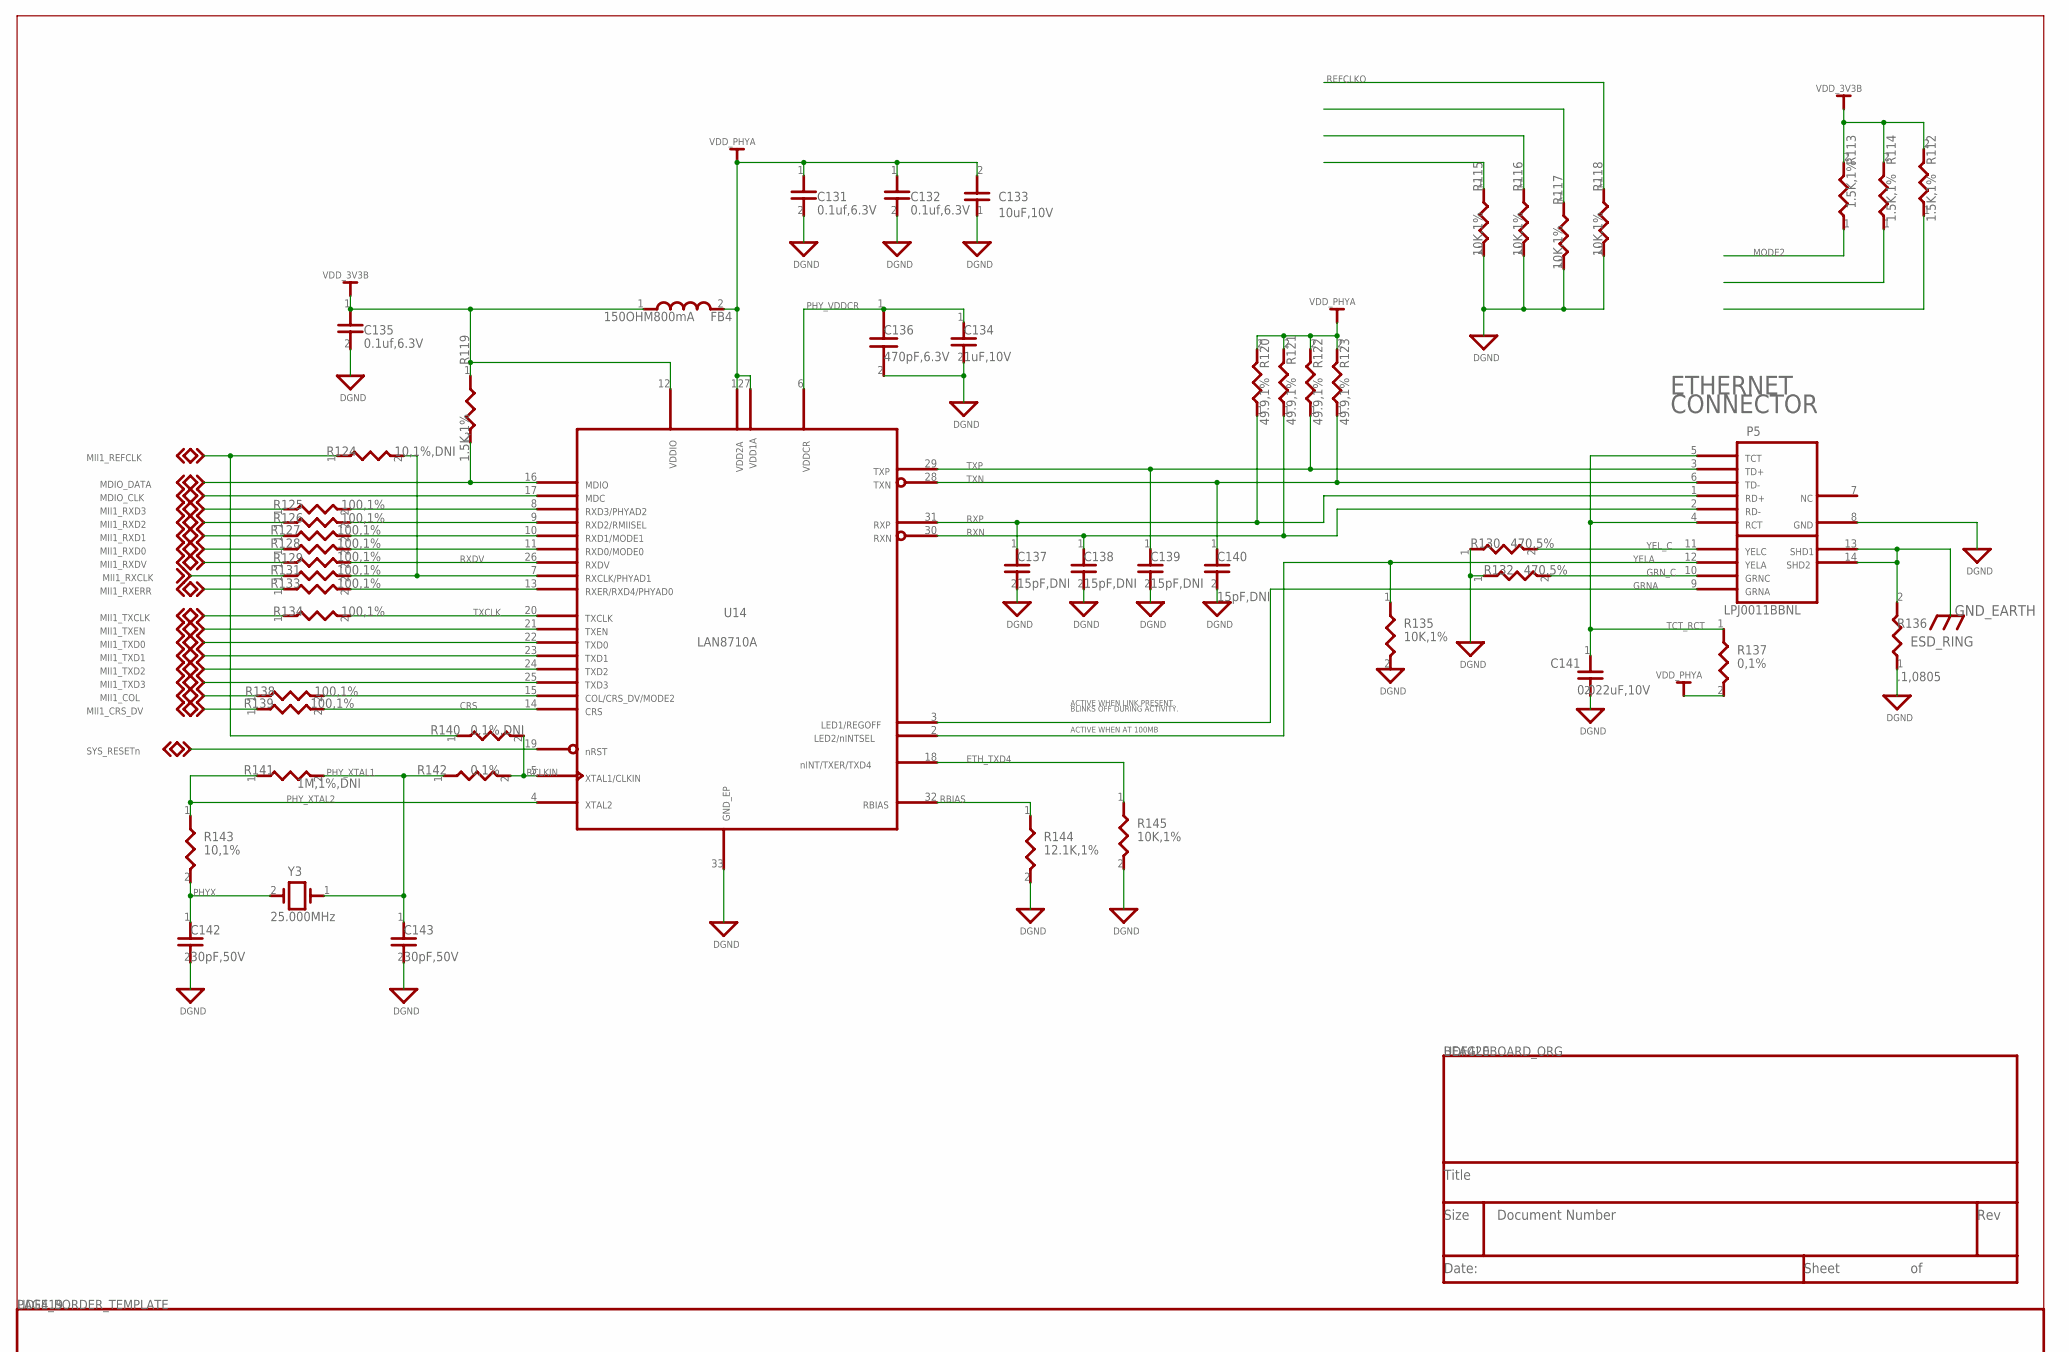
[picture p11: schematic BeagleBone_Black_egl.sch, sheet 9, part in row 1, column 1]

Parts:
C131, C132, C135: 0.1uf,6.3V; 402
C133: 10uF,10V; 805
C134: 1uF,10V; 402
C136: 470pF,6.3V; 0402
C137, C138, C139, C140: 15pF,DNI; 402
C141: 0.022uF,10V; 402
C142, C143: 30pF,50V; 402
FB4: 150OHM800mA; SM-7351-IND-0805
P5: LPJ0011BBNL; RJ45-7499010211A
R112, R113, R114, R119: 1.5K,1%; 402
R115, R116, R117, R118, R135, R145: 10K,1%; 402
R120, R121, R122, R123: 49.9,1%; 402
R124: 10,1%,DNI; 402
R125, R126, R127, R128, R129, R131, R133, R134, R138, R139: 100,1%; 402
R130, R132: 470,5%; 402
R136: .1,0805; 805
R137, R142: 0,1%; 402
R140: 0,1%,DNI; 402
R141: 1M,1%,DNI; 402
R143: 10,1%; 402
R144: 12.1K,1%; 402
U14: LAN8710A; QFN32_5X5MM_EP3P3MM
Y3: 25.000MHz; XTAL150SMD_125X196

Connections:
CRS: R139.2, U14.14 (17)
DGND: C131.2, C132.2, C133.1, C134.2, C135.2, C136.2, C137.2, C138.2, C139.2, C140.2, C141.2, C142.2, C143.2, P5.8 (11), R115.2, R116.2, R117.2, R118.2, R130.1, R132.1, R135.2, R136.1, R144.2, R145.2, U14.33 (21); also elsewhere on the board
ETH_TXD4: R145.1, U14.18 (31)
GND_EARTH: P5.13 (12), P5.14 (13), R136.2; also elsewhere on the board
GRNA: P5.9 (10), U14.3 (33)
GRN_C: P5.10 (9), R132.2
MDIO_CLK: U14.17 (2); also elsewhere on the board
MDIO_DATA: R119.2, U14.16 (1); also elsewhere on the board
MII1_COL: R138.1; also elsewhere on the board
MII1_CRS_DV: R139.1; also elsewhere on the board
MII1_REFCLK: R124.1, R140.1; also elsewhere on the board
MII1_RXCLK: R131.1; also elsewhere on the board
MII1_RXD0: R128.1; also elsewhere on the board
MII1_RXD1: R127.1; also elsewhere on the board
MII1_RXD2: R126.1; also elsewhere on the board
MII1_RXD3: R125.1; also elsewhere on the board
MII1_RXDV: R129.1; also elsewhere on the board
MII1_RXERR: R133.1; also elsewhere on the board
MII1_TXCLK: R134.1; also elsewhere on the board
MII1_TXD0: U14.22 (12); also elsewhere on the board
MII1_TXD1: U14.23 (13); also elsewhere on the board
MII1_TXD2: U14.24 (14); also elsewhere on the board
MII1_TXD3: U14.25 (15); also elsewhere on the board
MII1_TXEN: U14.21 (11); also elsewhere on the board
MODE2: R113.1, R138.2, U14.15 (16)
PHYX: C142.1, R143.2, Y3.2
PHY_VDDCR: C134.1, C136.1, U14.6 (26)
PHY_XTAL1: C143.1, R141.2, R142.1, Y3.1
PHY_XTAL2: R141.1, R143.1, U14.4 (20)
RBIAS: R144.1, U14.32 (22)
RCLKIN: R140.2, R142.2, U14.5 (19)
REFCLKO: R118.1, R124.2, R131.2, U14.7 (8)
RXD0\MODE0\: R112.1, R128.2, U14.11 (6)
RXD1\MODE1\: R114.1, R127.2, U14.10 (5)
RXD2\RMIISEL\: R117.1, R126.2, U14.9 (4)
RXD3\PHYAD2\: R116.1, R125.2, U14.8 (3)
RXDV: R129.2, U14.26 (7)
RXER\PHYAD0\: R115.1, R133.2, U14.13 (9)
RXN: C138.1, P5.2 (5), R121.1, U14.30 (28)
RXP: C137.1, P5.1 (4), R120.1, U14.31 (27)
SYS_RESETN: U14.19 (18); also elsewhere on the board
TCT_RCT: C141.1, P5.4 (6), P5.5 (1), R137.1
TXCLK: R134.2, U14.20 (10)
TXN: C140.1, P5.6 (3), R123.1, U14.28 (29)
TXP: C139.1, P5.3 (2), R122.1, U14.29 (30)
VDD_3V3B: C135.1, FB4.1, R112.2, R113.2, R114.2, R119.1, U14.12 (23); also elsewhere on the board
VDD_PHYA: C131.1, C132.1, C133.2, FB4.2, R120.2, R121.2, R122.2, R123.2, R137.2, U14.1 (25), U14.27 (24)
YELA: P5.12 (8), R135.1, U14.2 (32)
YEL_C: P5.11 (7), R130.2

Notes on the sheet:
ESD_RING
ACTIVE WHEN LINK PRESENT.
BLINKS OFF DURING ACTIVITY.
ACTIVE WHEN AT 100MB
ETHERNET
CONNECTOR
DGND
GND_EARTH
VDD_3V3B
SYS_RESETn
MDIO_CLK
MDIO_DATA
MII1_COL
MII1_CRS_DV
MII1_REFCLK
MII1_RXCLK
MII1_RXD0
MII1_RXD1
MII1_RXD2
MII1_RXD3
MII1_RXDV
MII1_RXERR
MII1_TXCLK
MII1_TXD0
MII1_TXD1
MII1_TXD2
MII1_TXD3
MII1_TXEN
CRS
ETH_TXD4
GRNA
GRN_C
MODE2
PHYX
PHY_VDDCR
PHY_XTAL1
PHY_XTAL2
RBIAS
RCLKIN
REFCLKO
RXDV
RXN
RXP
TCT_RCT
TXCLK
TXN
TXP
VDD_PHYA
YELA
YEL_C

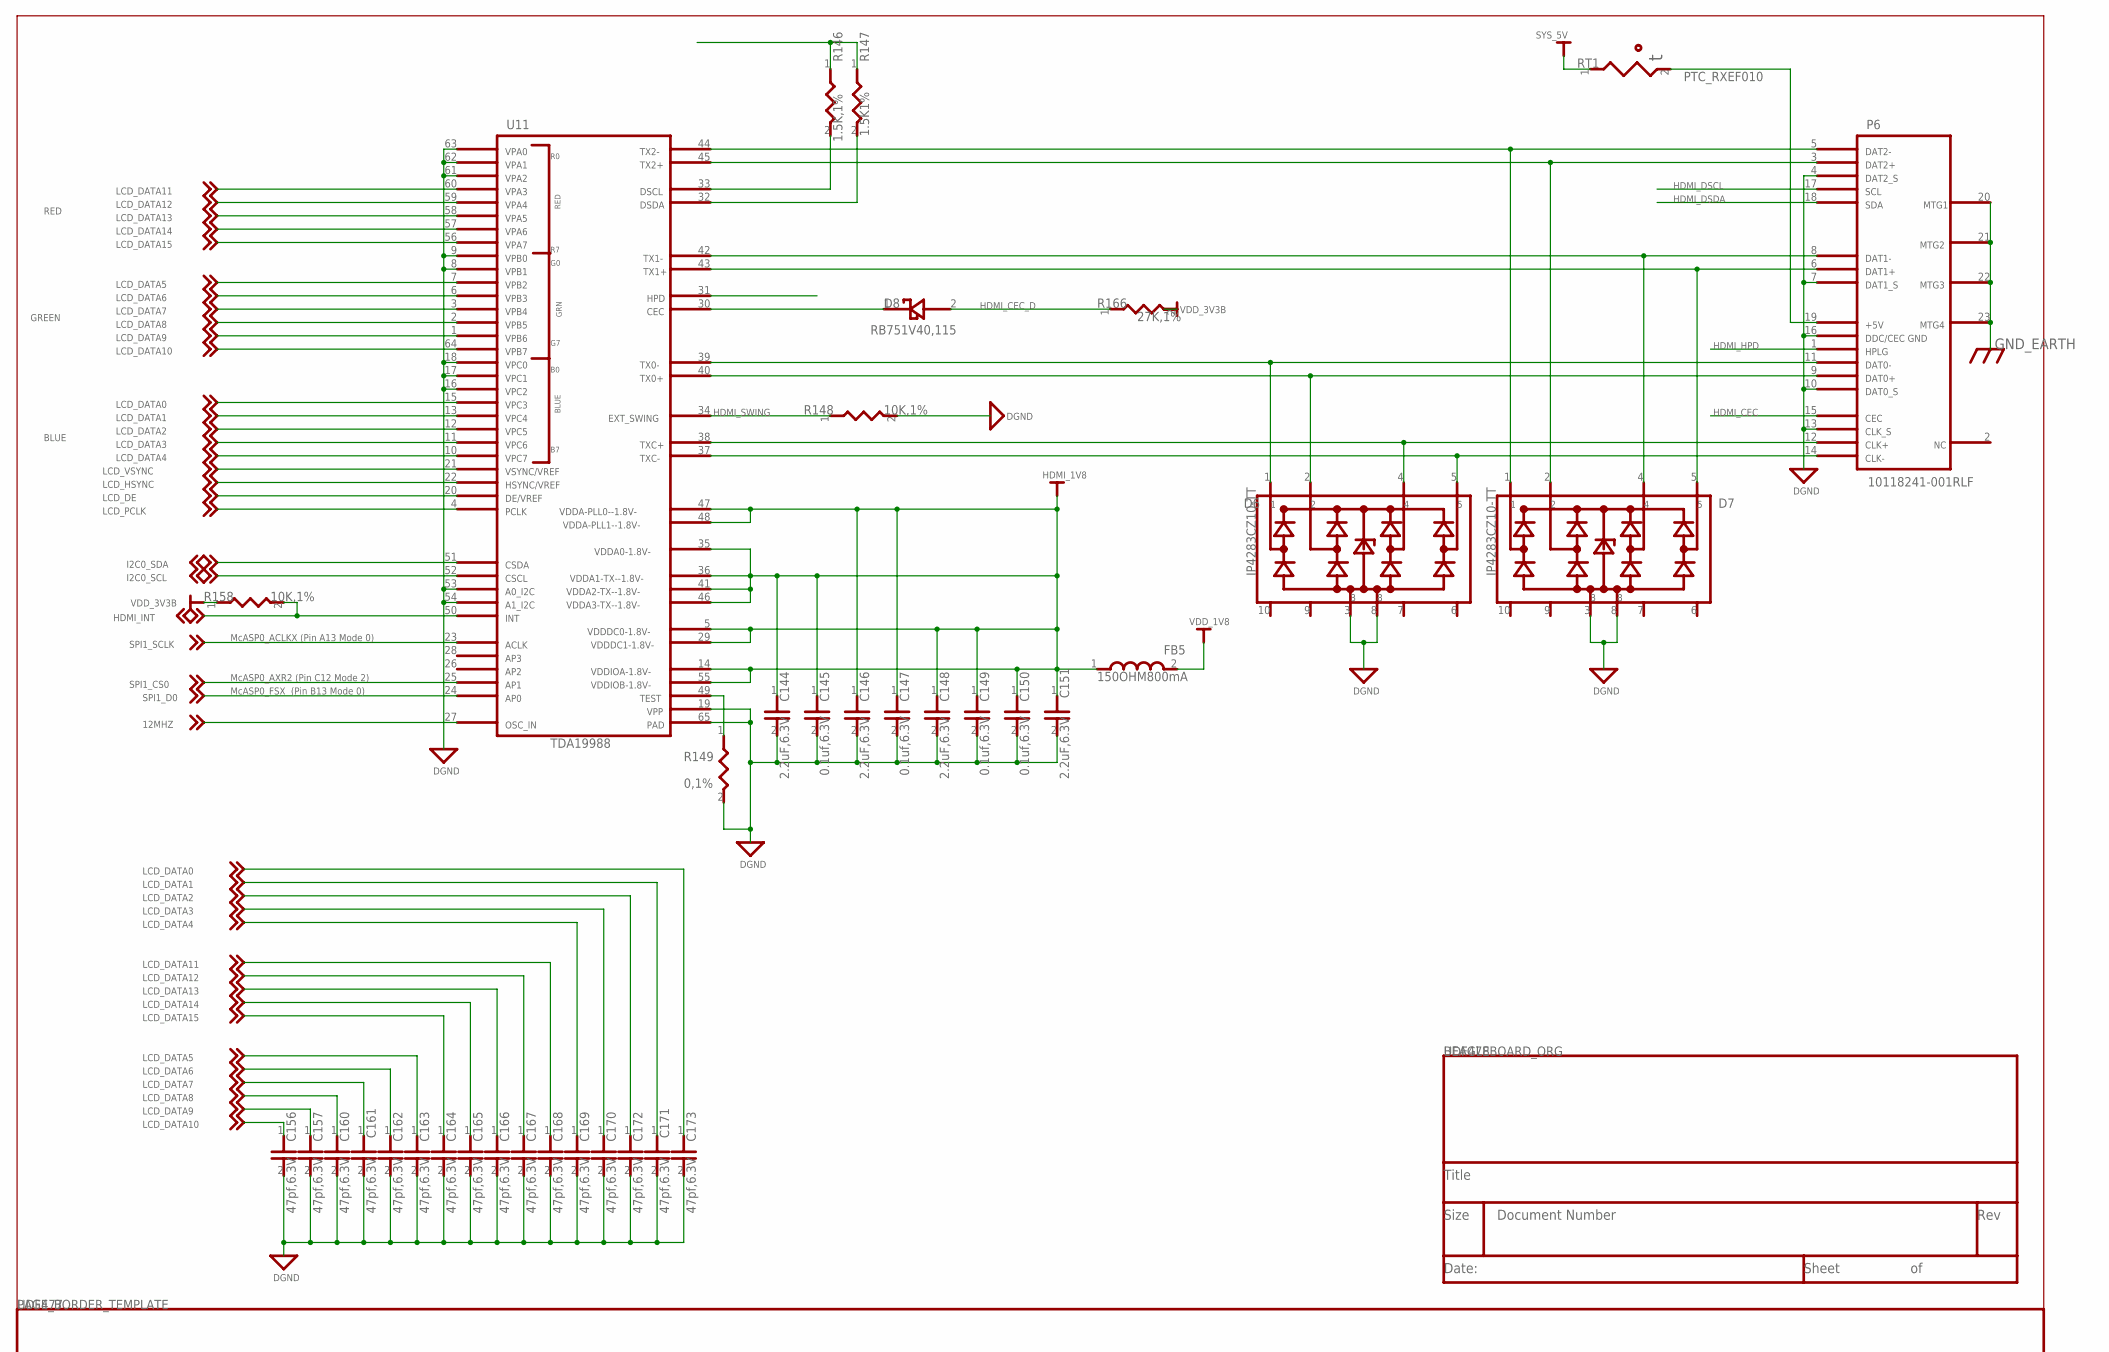
[picture p12: schematic BeagleBone_Black_egl.sch, sheet 10, part in row 1, column 1]

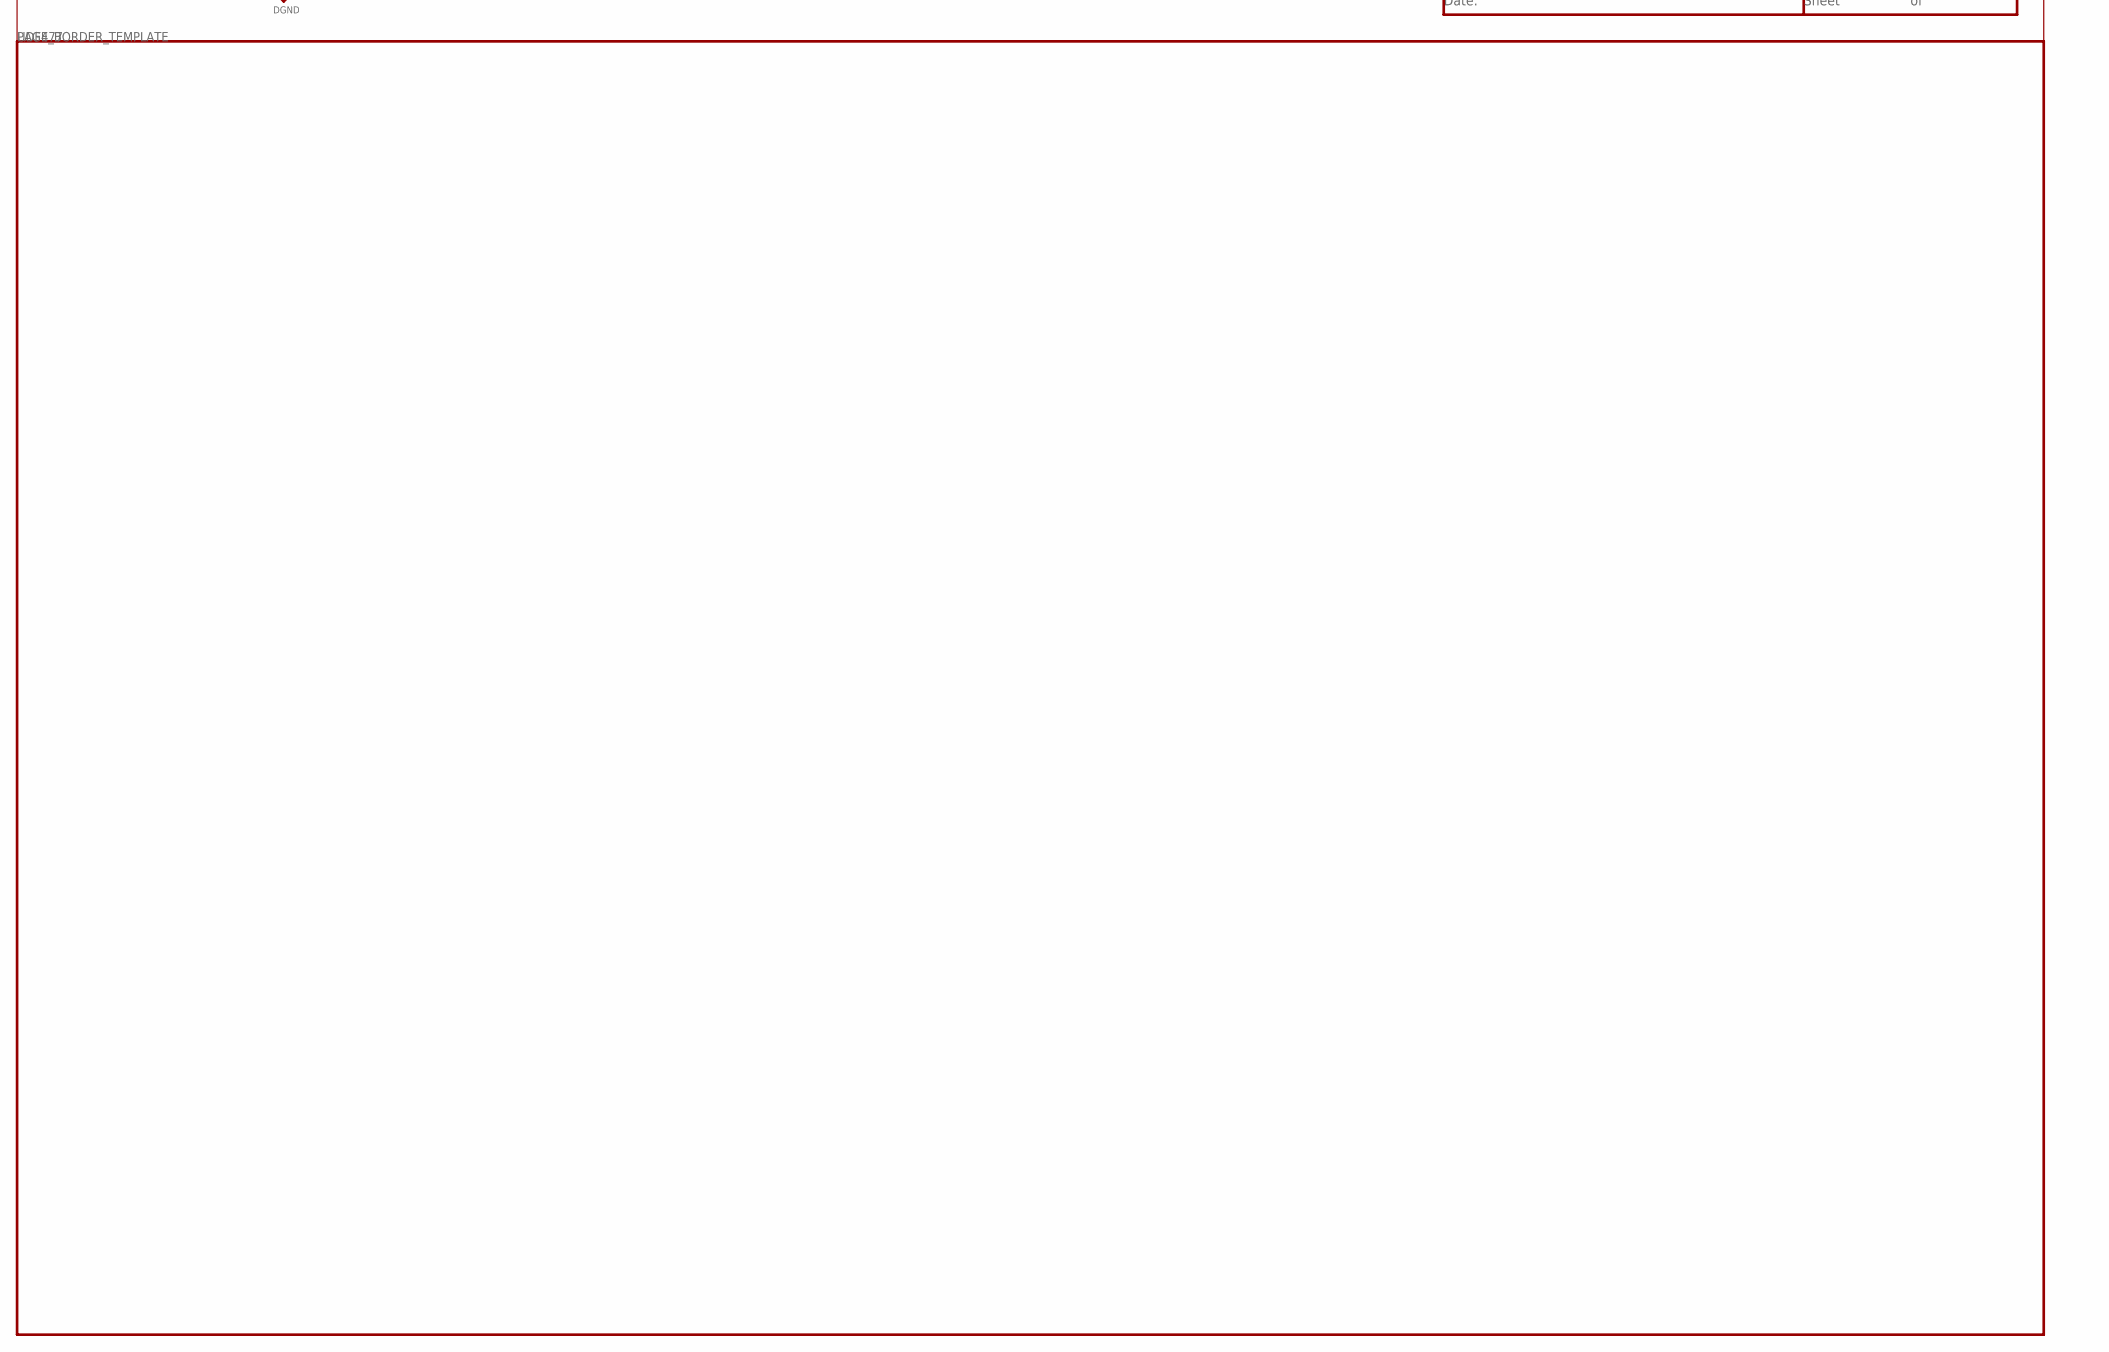
[picture p13: schematic BeagleBone_Black_egl.sch, sheet 10, part in row 2, column 1]

Parts:
C144, C146, C148, C151: 2.2uF,6.3V; 402
C145, C147, C149, C150: 0.1uf,6.3V; 402
C156, C157, C160, C161, C162, C163, C164, C165, C166, C167, C168, C169, C170, C171, C172, C173: 47pf,6.3V; 402
D6, D7: IP4283CZ10-TT; TSSOP10
D8: RB751V40,115; SOD323
FB5: 150OHM800mA; SM-7351-IND-0805
P6: 10118241-001RLF; CONN19_HDMI
R146: 1.5K,1%; 402
R147: 1.5K1%; 402
R148, R158: 10K,1%; 402
R149: 0,1%; 402
R166: 27K,1%; 402
RT1: PTC_RXEF010; POLYSW200-5638-310
U11: TDA19988; QFN64S9X9P5

Connections:
12MHZ: U11.27 (59); also elsewhere on the board
DGND: C144.2, C145.2, C146.2, C147.2, C148.2, C149.2, C150.2, C151.2, C156.2, C157.2, C160.2, C161.2, C162.2, C163.2, C164.2, C165.2, C166.2, C167.2, C168.2, C169.2, C170.2, C171.2, C172.2, C173.2, D6.3 (6), D6.8 (3), D7.3 (6), D7.8 (3), P6.4 (3), P6.7 (5), P6.10 (8), P6.13 (12), P6.16 (17), R148.2, R149.2, U11.8 (10), U11.9, U11.16 (19), U11.17 (18), U11.18 (17), U11.19 (50), U11.53 (57), U11.54 (58), U11.61 (3), U11.62 (2), U11.63 (1), U11.65; also elsewhere on the board
DVI_+5V: P6.19 (18), R146.1, R147.1, RT1.2
GND_EARTH: P6.20, P6.21, P6.22, P6.23; also elsewhere on the board
HDMI_1V8: C144.1, C145.1, C146.1, C147.1, C148.1, C149.1, C150.1, C151.1, FB5.1, U11.5 (55), U11.14 (49), U11.29 (56), U11.35 (53), U11.36 (54), U11.41 (61), U11.46 (62), U11.47 (52), U11.48 (63), U11.55 (64)
HDMI_CEC: D8.1 (2), P6.15 (13), U11.30 (34)
HDMI_CEC_D: D8.2 (1), R166.1
HDMI_DSCL: P6.17 (15), R146.2, U11.33 (28)
HDMI_DSDA: P6.18 (16), R147.2, U11.32 (29)
HDMI_HPD: P6.1 (19), U11.31 (32)
HDMI_INT: R158.2, U11.50 (33); also elsewhere on the board
HDMI_SWING: R148.1, U11.34 (47)
HDMI_TX0+: D6.2, P6.9 (7), U11.40 (37)
HDMI_TX0-: D6.1, P6.11 (9), U11.39 (38)
HDMI_TX1+: D7.5, P6.6 (4), U11.43 (39)
HDMI_TX1-: D7.4, P6.8 (6), U11.42 (40)
HDMI_TX2+: D7.2, P6.3 (1), U11.45 (41)
HDMI_TX2-: D7.1, P6.5 (2), U11.44 (42)
HDMI_TXC+: D6.4, P6.12 (10), U11.38 (35)
HDMI_TXC-: D6.5, P6.14 (11), U11.37 (36)
I2C0_SCL: U11.52 (30); also elsewhere on the board
I2C0_SDA: U11.51 (31); also elsewhere on the board
LCD_DATA0: C173.1, U11.15 (20); also elsewhere on the board
LCD_DATA1: C171.1, U11.13 (21); also elsewhere on the board
LCD_DATA2: C172.1, U11.12 (22); also elsewhere on the board
LCD_DATA3: C170.1, U11.11 (23); also elsewhere on the board
LCD_DATA4: C169.1, U11.10 (24); also elsewhere on the board
LCD_DATA5: C163.1, U11.7 (11); also elsewhere on the board
LCD_DATA6: C162.1, U11.6 (12); also elsewhere on the board
LCD_DATA7: C161.1, U11.3 (13); also elsewhere on the board
LCD_DATA8: C160.1, U11.2 (14); also elsewhere on the board
LCD_DATA9: C157.1, U11.1 (15); also elsewhere on the board
LCD_DATA10: C156.1, U11.64 (16); also elsewhere on the board
LCD_DATA11: C168.1, U11.60 (4); also elsewhere on the board
LCD_DATA12: C167.1, U11.59 (5); also elsewhere on the board
LCD_DATA13: C166.1, U11.58 (6); also elsewhere on the board
LCD_DATA14: C165.1, U11.57 (7); also elsewhere on the board
LCD_DATA15: C164.1, U11.56 (8); also elsewhere on the board
LCD_DE: U11.20 (27); also elsewhere on the board
LCD_HSYNC: U11.22 (26); also elsewhere on the board
LCD_PCLK: U11.4 (43); also elsewhere on the board
LCD_VSYNC: U11.21 (25); also elsewhere on the board
N21667305: R149.1, U11.49 (51)
SPI1_CS0: U11.25 (46); also elsewhere on the board
SPI1_D0: U11.24 (45); also elsewhere on the board
SPI1_SCLK: U11.23 (44); also elsewhere on the board
SYS_5V: RT1.1; also elsewhere on the board
VDD_1V8: FB5.2; also elsewhere on the board
VDD_3V3B: R158.1, R166.2; also elsewhere on the board

Notes on the sheet:
GREEN
RED
BLUE
McASP0_ACLKX (Pin A13 Mode 0)
McASP0_AXR2 (Pin C12 Mode 2)
McASP0_FSX (Pin B13 Mode 0)
DGND
GND_EARTH
I2C0_SCL
I2C0_SDA
SYS_5V
VDD_1V8
VDD_3V3B
12MHZ
HDMI_INT
LCD_DATA0
LCD_DATA1
LCD_DATA10
LCD_DATA11
LCD_DATA12
LCD_DATA13
LCD_DATA14
LCD_DATA15
LCD_DATA2
LCD_DATA3
LCD_DATA4
LCD_DATA5
LCD_DATA6
LCD_DATA7
LCD_DATA8
LCD_DATA9
LCD_DE
LCD_HSYNC
LCD_PCLK
LCD_VSYNC
SPI1_CS0
SPI1_D0
SPI1_SCLK
HDMI_1V8
HDMI_CEC
HDMI_CEC_D
HDMI_DSCL
HDMI_DSDA
HDMI_HPD
HDMI_SWING
