mrpackethead/bbb_eagle/BeagleBone_Black_egl.brd

## EAGLE design BeagleBone_Black_egl.brd (continued)

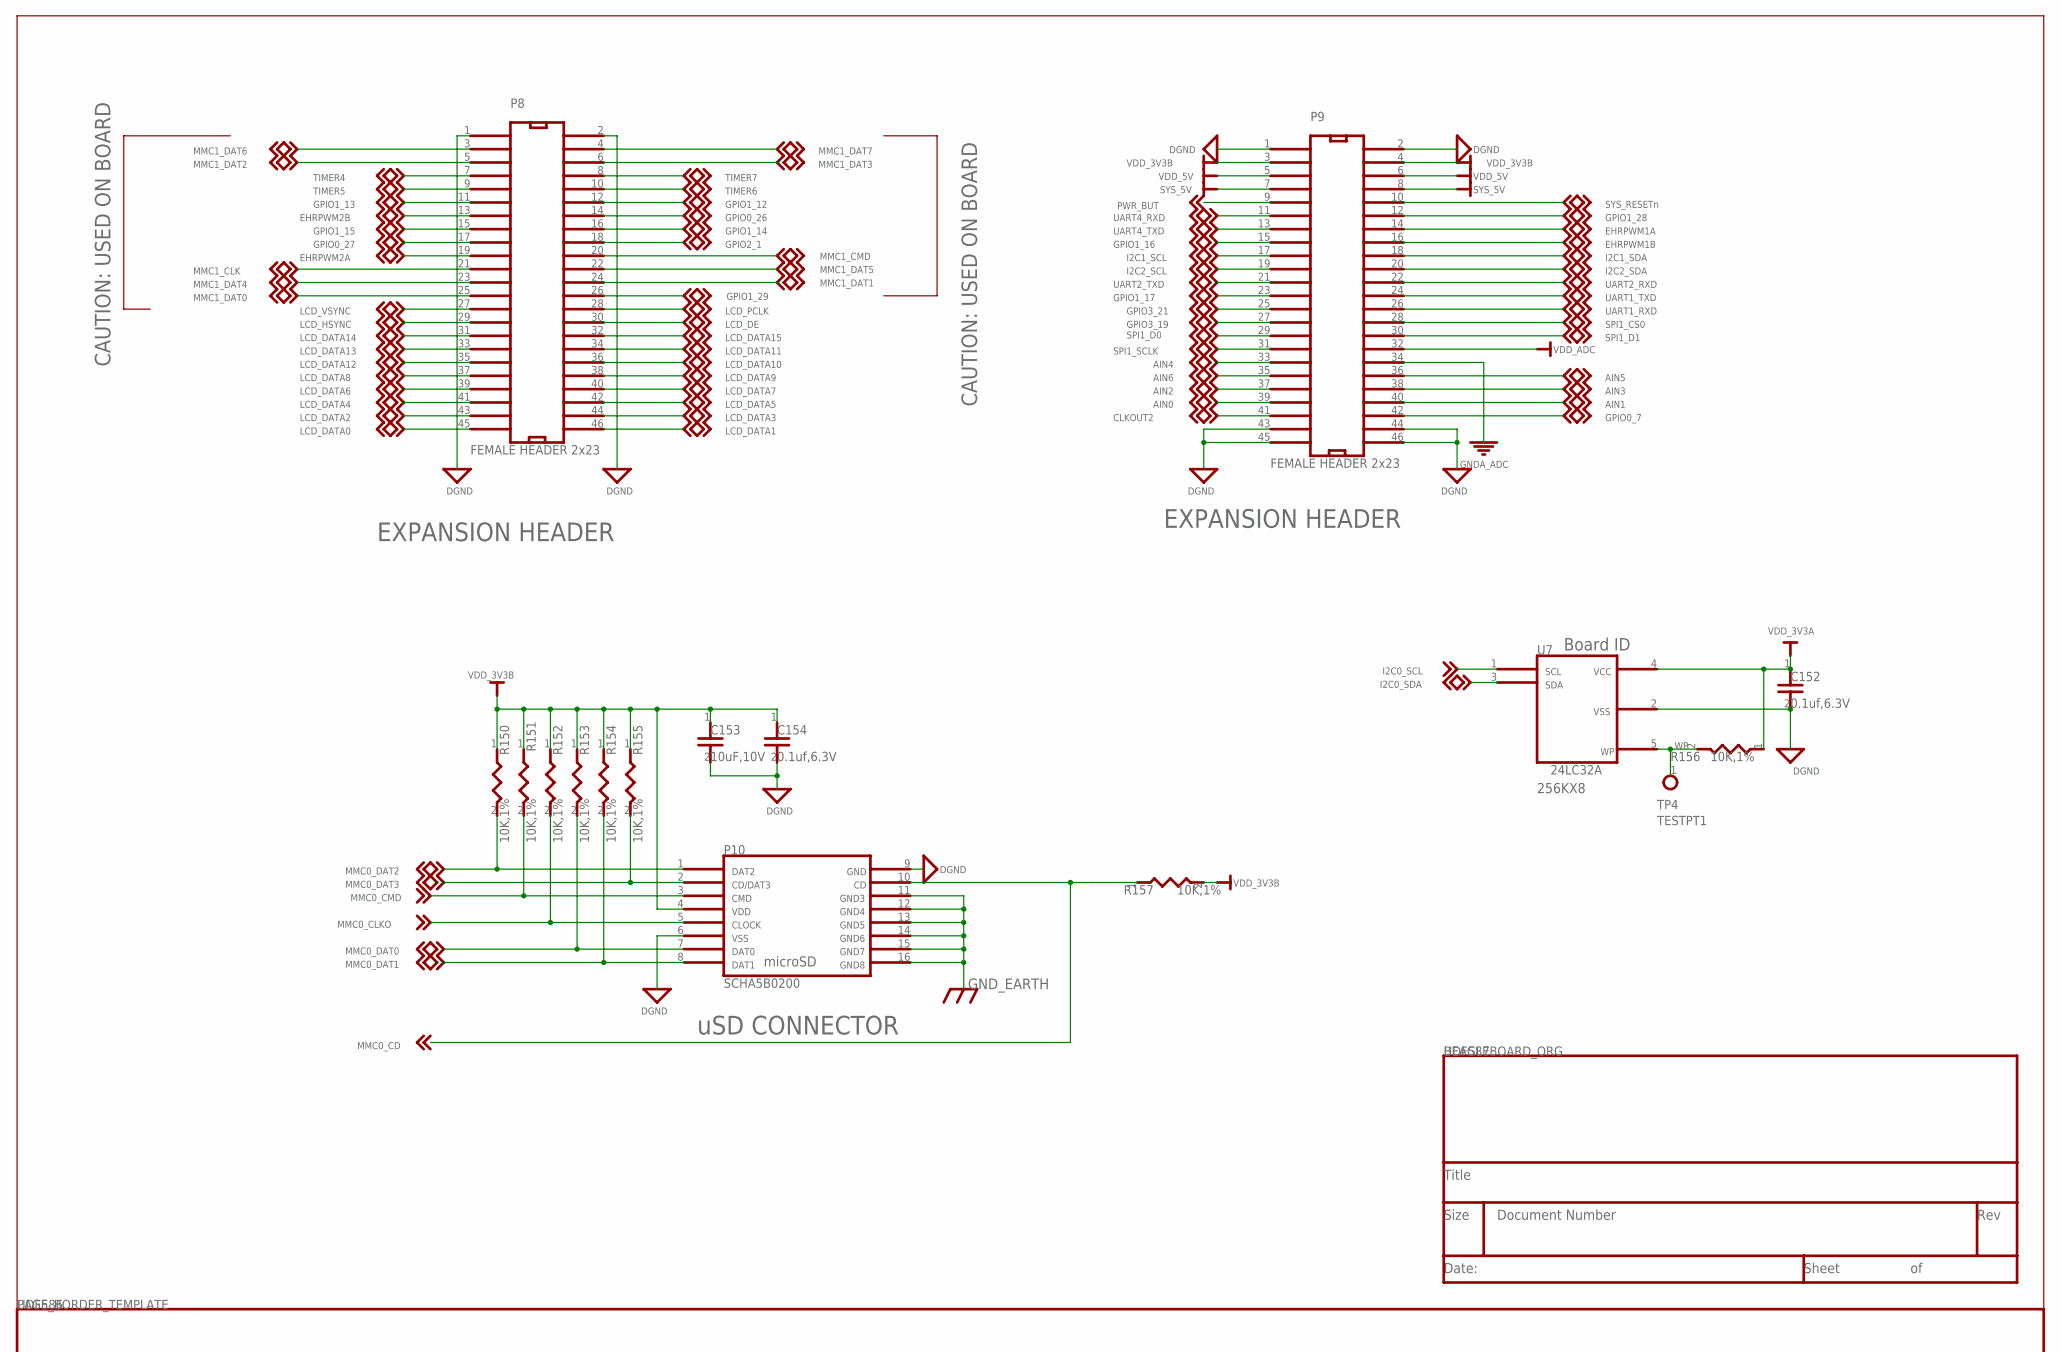
[picture p14: schematic BeagleBone_Black_egl.sch, sheet 11, part in row 1, column 1]

Parts:
C152, C154: 0.1uf,6.3V; 402
C153: 10uF,10V; 805
P8, P9: FEMALE HEADER 2x23; HEADER23X2
P10: SCHA5B0200; SD-MICRO-SCHA5B0300
R150, R151, R152, R153, R154, R155, R156, R157: 10K,1%; 402
TP4: TESTPT1; TP1-8040
U7: 24LC32A; SOT23-5

Connections:
AIN0: P9.39 (43); also elsewhere on the board
AIN1: P9.40 (20); also elsewhere on the board
AIN2: P9.37 (42); also elsewhere on the board
AIN3: P9.38 (19); also elsewhere on the board
AIN4: P9.33 (40); also elsewhere on the board
AIN5: P9.36 (18); also elsewhere on the board
AIN6: P9.35 (41); also elsewhere on the board
CLKOUT2: P9.41 (44); also elsewhere on the board
DGND: C152.2, C153.2, C154.2, P8.1 (24), P8.2 (1), P9.1 (24), P9.2 (1), P9.43 (45), P9.44 (22), P9.45 (46), P9.46 (23), P10.6, P10.9, U7.2 (4); also elsewhere on the board
EHRPWM1A: P9.14 (7); also elsewhere on the board
EHRPWM1B: P9.16 (8); also elsewhere on the board
EHRPWM2A: P8.19 (33); also elsewhere on the board
EHRPWM2B: P8.13 (30); also elsewhere on the board
GNDA_ADC: P9.34 (17); also elsewhere on the board
GND_EARTH: P10.11, P10.12, P10.13, P10.14, P10.15, P10.16; also elsewhere on the board
GPIO0_7: P9.42 (21); also elsewhere on the board
GPIO0_26: P8.14 (7); also elsewhere on the board
GPIO0_27: P8.17 (32); also elsewhere on the board
GPIO1_12: P8.12 (6); also elsewhere on the board
GPIO1_13: P8.11 (29); also elsewhere on the board
GPIO1_14: P8.16 (8); also elsewhere on the board
GPIO1_15: P8.15 (31); also elsewhere on the board
GPIO1_16: P9.15 (31); also elsewhere on the board
GPIO1_17: P9.23 (35); also elsewhere on the board
GPIO1_28: P9.12 (6); also elsewhere on the board
GPIO1_29: P8.26 (13); also elsewhere on the board
GPIO2_1: P8.18 (9); also elsewhere on the board
GPIO3_19: P9.27 (37); also elsewhere on the board
GPIO3_21: P9.25 (36); also elsewhere on the board
I2C0_SCL: U7.1; also elsewhere on the board
I2C0_SDA: U7.3 (2); also elsewhere on the board
I2C1_SCL: P9.17 (32); also elsewhere on the board
I2C1_SDA: P9.18 (9); also elsewhere on the board
I2C2_SCL: P9.19 (33); also elsewhere on the board
I2C2_SDA: P9.20 (10); also elsewhere on the board
LCD_DATA0: P8.45 (46); also elsewhere on the board
LCD_DATA1: P8.46 (23); also elsewhere on the board
LCD_DATA2: P8.43 (45); also elsewhere on the board
LCD_DATA3: P8.44 (22); also elsewhere on the board
LCD_DATA4: P8.41 (44); also elsewhere on the board
LCD_DATA5: P8.42 (21); also elsewhere on the board
LCD_DATA6: P8.39 (43); also elsewhere on the board
LCD_DATA7: P8.40 (20); also elsewhere on the board
LCD_DATA8: P8.37 (42); also elsewhere on the board
LCD_DATA9: P8.38 (19); also elsewhere on the board
LCD_DATA10: P8.36 (18); also elsewhere on the board
LCD_DATA11: P8.34 (17); also elsewhere on the board
LCD_DATA12: P8.35 (41); also elsewhere on the board
LCD_DATA13: P8.33 (40); also elsewhere on the board
LCD_DATA14: P8.31 (39); also elsewhere on the board
LCD_DATA15: P8.32 (16); also elsewhere on the board
LCD_DE: P8.30 (15); also elsewhere on the board
LCD_HSYNC: P8.29 (38); also elsewhere on the board
LCD_PCLK: P8.28 (14); also elsewhere on the board
LCD_VSYNC: P8.27 (37); also elsewhere on the board
MMC0_CD: P10.10, R157.1; also elsewhere on the board
MMC0_CLKO: P10.5, R152.2; also elsewhere on the board
MMC0_CMD: P10.3, R151.2; also elsewhere on the board
MMC0_DAT0: P10.7, R153.2; also elsewhere on the board
MMC0_DAT1: P10.8, R154.2; also elsewhere on the board
MMC0_DAT2: P10.1, R150.2; also elsewhere on the board
MMC0_DAT3: P10.2, R155.2; also elsewhere on the board
MMC1_CLK: P8.21 (34); also elsewhere on the board
MMC1_CMD: P8.20 (10); also elsewhere on the board
MMC1_DAT0: P8.25 (36); also elsewhere on the board
MMC1_DAT1: P8.24 (12); also elsewhere on the board
MMC1_DAT2: P8.5 (26); also elsewhere on the board
MMC1_DAT3: P8.6 (3); also elsewhere on the board
MMC1_DAT4: P8.23 (35); also elsewhere on the board
MMC1_DAT5: P8.22 (11); also elsewhere on the board
MMC1_DAT6: P8.3 (25); also elsewhere on the board
MMC1_DAT7: P8.4 (2); also elsewhere on the board
PWR_BUT: P9.9 (28); also elsewhere on the board
SPI1_CS0: P9.28 (14); also elsewhere on the board
SPI1_D0: P9.29 (38); also elsewhere on the board
SPI1_D1: P9.30 (15); also elsewhere on the board
SPI1_SCLK: P9.31 (39); also elsewhere on the board
SYS_5V: P9.7 (27), P9.8 (4); also elsewhere on the board
SYS_RESETN: P9.10 (5); also elsewhere on the board
TIMER4: P8.7 (27); also elsewhere on the board
TIMER5: P8.9 (28); also elsewhere on the board
TIMER6: P8.10 (5); also elsewhere on the board
TIMER7: P8.8 (4); also elsewhere on the board
UART1_RXD: P9.26 (13); also elsewhere on the board
UART1_TXD: P9.24 (12); also elsewhere on the board
UART2_RXD: P9.22 (11); also elsewhere on the board
UART2_TXD: P9.21 (34); also elsewhere on the board
UART4_RXD: P9.11 (29); also elsewhere on the board
UART4_TXD: P9.13 (30); also elsewhere on the board
VDD_3V3A: C152.1, R156.1, U7.4 (3); also elsewhere on the board
VDD_3V3B: C153.1, C154.1, P9.3 (25), P9.4 (2), P10.4, R150.1, R151.1, R152.1, R153.1, R154.1, R155.1, R157.2; also elsewhere on the board
VDD_5V: P9.5 (26), P9.6 (3); also elsewhere on the board
VDD_ADC: P9.32 (16); also elsewhere on the board
WP: R156.2, TP4.1, U7.5

Notes on the sheet:
EXPANSION HEADER
Board ID
256KX8
uSD CONNECTOR
CAUTION: USED ON BOARD
DGND
GND_EARTH
I2C0_SCL
I2C0_SDA
PWR_BUT
SYS_5V
VDD_3V3A
VDD_3V3B
VDD_5V
CLKOUT2
EHRPWM1A
EHRPWM1B
EHRPWM2A
EHRPWM2B
GPIO0_26
GPIO0_27
GPIO1_12
GPIO1_13
GPIO1_14
GPIO1_15
GPIO1_16
GPIO1_17
GPIO1_28
GPIO1_29
GPIO2_1
GPIO3_21
MMC0_CD
MMC0_CLKO
MMC0_CMD
MMC0_DAT0
MMC0_DAT1
MMC0_DAT2
MMC0_DAT3
MMC1_CLK
MMC1_CMD
MMC1_DAT0
MMC1_DAT1
MMC1_DAT2
MMC1_DAT3
MMC1_DAT4
MMC1_DAT5
MMC1_DAT6
MMC1_DAT7
SYS_RESETn
TIMER4
TIMER5
TIMER6
TIMER7
UART4_RXD
UART4_TXD
AIN0
AIN1
AIN2
AIN3
AIN4
AIN5
AIN6
GNDA_ADC
GPIO0_7
GPIO3_19
I2C1_SCL
I2C1_SDA
I2C2_SCL
I2C2_SDA
LCD_DATA0
LCD_DATA1
LCD_DATA10
LCD_DATA11
LCD_DATA12
LCD_DATA13
LCD_DATA14
LCD_DATA15
LCD_DATA2
LCD_DATA3
LCD_DATA4
LCD_DATA5
LCD_DATA6
LCD_DATA7
LCD_DATA8
LCD_DATA9
LCD_DE
LCD_HSYNC
LCD_PCLK
LCD_VSYNC
SPI1_CS0
SPI1_D0
SPI1_D1
SPI1_SCLK
UART1_RXD
UART1_TXD
UART2_RXD
UART2_TXD
VDD_ADC

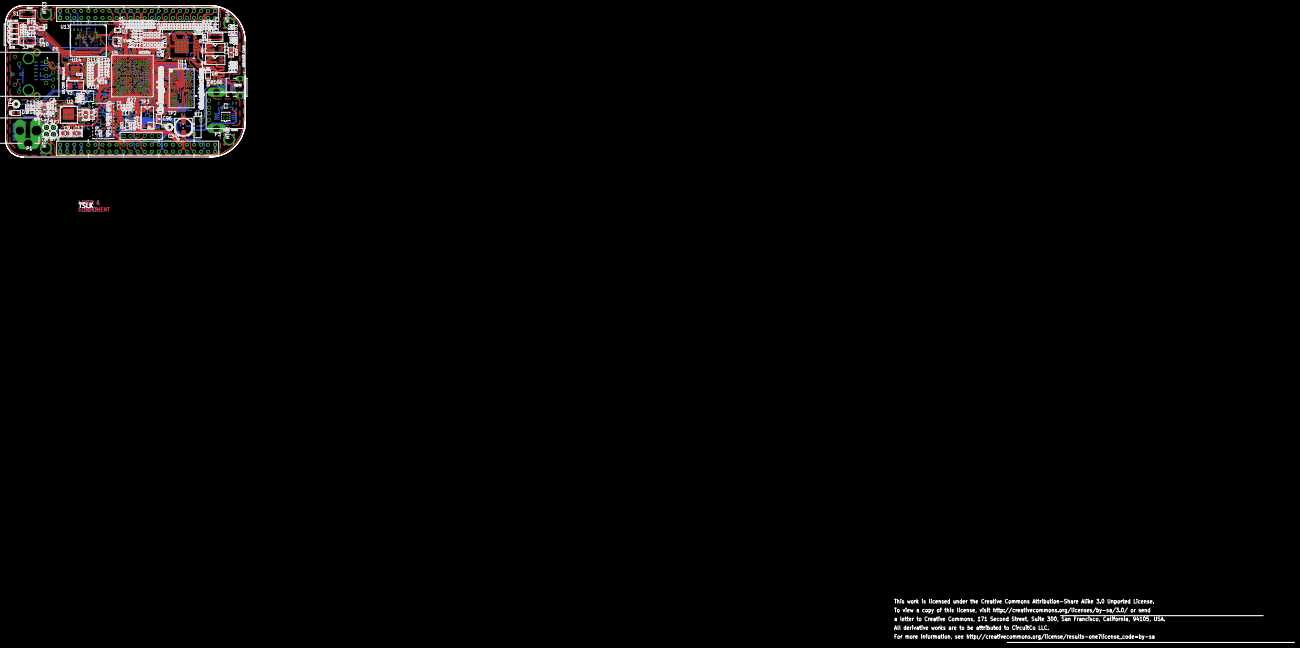
[picture p15: board BeagleBone_Black_egl.brd from above]

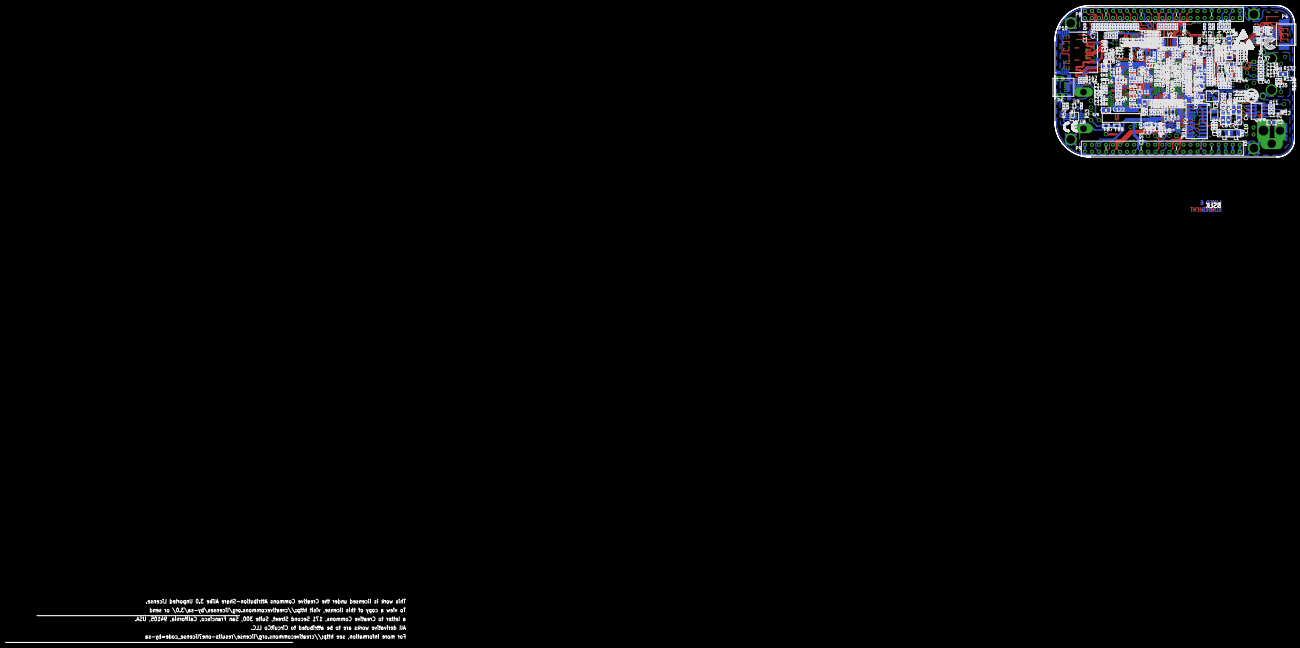
[picture p16: board BeagleBone_Black_egl.brd from below]

Board: 6 copper layers, 86.4 x 54.6 mm, 389 parts (253 on the bottom side), 310 nets.

Other parts of the board:
FZ3, FZ4, FZ5, FZ6, FZ7, FZ8: FUD40C
MECH1, MECH2: CREATIVE_COMMONS_NOTE
