mrpackethead/bbb_eagle/(notices)

Notices in the files:
BeagleBone_Black_egl.brd:
For more information, see http://creativecommons.org/license/results-one?license_code=by-sa
a letter to Creative Commons, 171 Second Street, Suite 300, San Francisco, California, 94105, USA.
To view a copy of this license, visit http://creativecommons.org/licenses/by-sa/3.0/ or send
This work is licensed under the Creative Commons Attribution-Share Alike 3.0 Unported License.
